sps80-SaiSingaravelan/Synthesiser-Project/SynthesizerProject_QMS/Documents gallery/Figures & Diagrams/260312-SynthesizerProject-LCA Diagram-V1.png

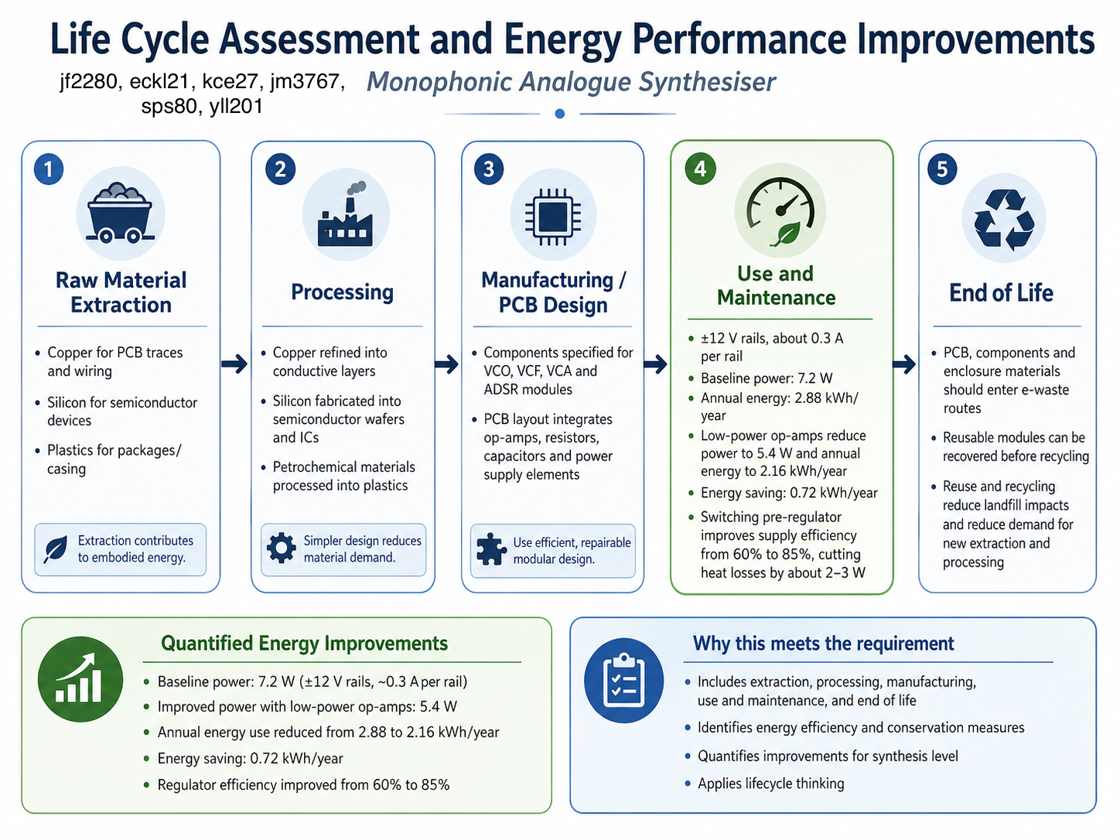
SynthesizerProject_QMS/Documents gallery/Figures & Diagrams/260312-SynthesizerProject-LCA Diagram-V1.png
