sps80-SaiSingaravelan/Synthesiser-Project/README.md

# Synthesiser-Project
This is the repository for our Modular Synthesiser Project
