sps80-SaiSingaravelan/Synthesiser-Project/SynthesizerProject_QMS/Engineering/Measurements & Screenshots/260307-Synthesizer-EEE-ASREnvSchematic-v1-00.png

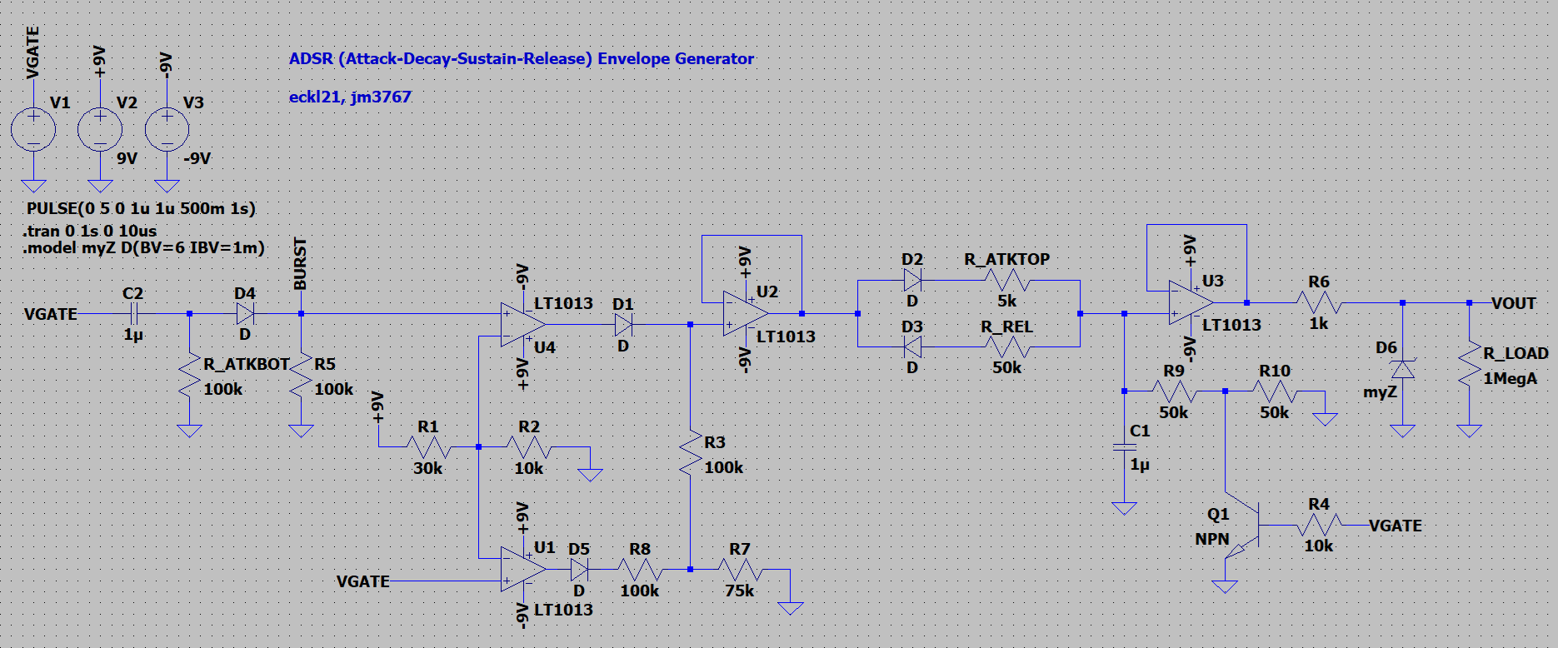
SynthesizerProject_QMS/Engineering/Measurements & Screenshots/260307-Synthesizer-EEE-ASREnvSchematic-v1-00.png
