sps80-SaiSingaravelan/Synthesiser-Project/SynthesizerProject_QMS/Engineering/PCB Layouts/ENV/20260428-Synthesizer-EEE-LT1013Symbol-v1-00.png

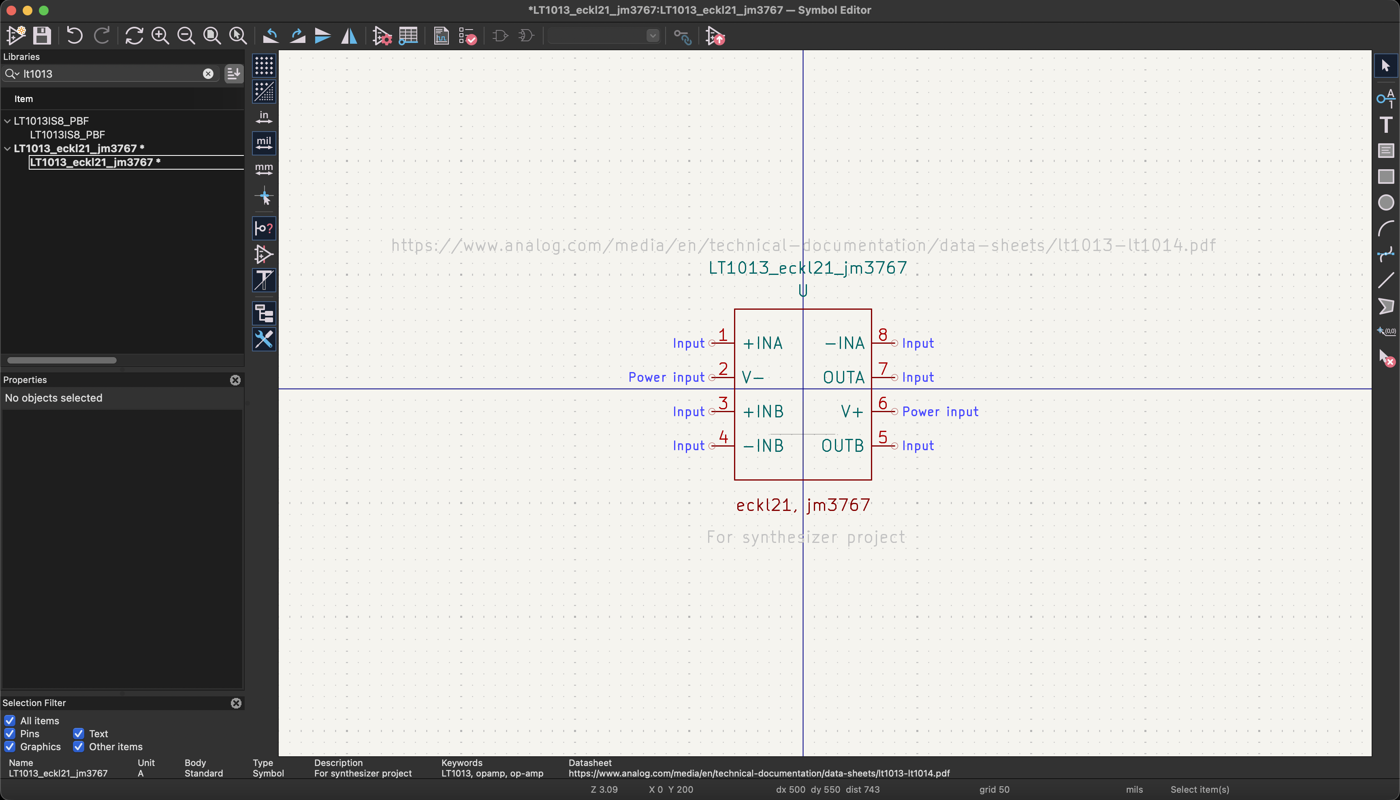
SynthesizerProject_QMS/Engineering/PCB Layouts/ENV/20260428-Synthesizer-EEE-LT1013Symbol-v1-00.png
