sps80-SaiSingaravelan/Synthesiser-Project/SynthesizerProject_QMS/Quality documents/D&D matrices/260308-SynthesizerProject-DDMatrixVCF-V1.xlsx

Sheet: Sheet1
 | VCF D&D Matrix |  |  | jm3767,eckl21,jf2280,kce27,sps80,yll201
Category | Needs analysis |  | Target specifications |  |  | Technical solution |  | Verification |  |  | Validation |  |  | Compliance
 | Ref Need | Description | Ref Spec | Description | Objectives measurable + tolerance | Possible solutions | The chosen one | Verification test description | Location/Team | Control methodology | Validation test description | Location/Team | Control methodology | Y/N
Performance | N1.1 | The synthesiser must shape the harmonic content of the VCO output using a voltage controlled filter. | S1.1 | Provide low-pass filtering of oscillator waveforms for subtractive synthesis. | Cut-off frequency adjustable from 100 Hz to 5 kHz ±10%, based on standard filter design principles [21]. | •Passive RC low-pass filter •Op-amp active low-pass filter •State-variable filter | Op-amp based active voltage controlled low-pass filter | LTspice simulation with square-wave input and confirm that cut-off point is within the target range. | 2 East Labs/ Team | Vary the control voltage in LTspice and observe the reduction of high-frequency content at the output | Perform LTspice AC sweep analysis to measure the -3 dB cut-off frequency at minimum, mid, and maximum control settings. | 2 East Labs / Team | Use AC analysis in LTspice to determine the frequency at which output amplitude drops by 3 dB relative to passband [20], [21]. Compare measured values against target range of 100 Hz to 5 kHz ±10%. | Y
Performance | N1.2 | The filter must operate over a useful part of the audible range [21] | S1.2 | Allow audible tone shaping over low to mid audio frequencies. | Usable filtering range covering at least 3 octaves, target 100 Hz to 5 kHz ±10%. | •Passive RC filter with variable resistor •Active op-amp filter •OTA filter | Active op-amp filter topology | Measure cut-off frequency at minimum and confirm coverage of the specified range. | 2 East Labs/ Team | Perform AC sweep in LTspice and record the −3 dB cut-off frequency [20], [21] | Perform AC sweep analysis to measure gain peak near the cut-off frequency at different resonance settings. | 2 East Labs / Team | Measure peak gain in LTspice frequency response and confirm it reaches at least +3 dB ±1 dB. Observe behaviour across low, medium, and high resonance settings [20], [22]. | Y
Usability | N2.1 | The VCF must accept the expected VCO signal level without significant distortion. | S2.1 | Process standard synthesiser-level audio signals without clipping in normal operation. | Input amplitude up to ±5 V ±5% without visible clipping or severe waveform deformation at the output [22]. | •Passive filter stage •Buffered active filter stage •OTA stage with buffer | Buffered op-amp active filter stage | Simulate with square-wave input and confirm output remains within supply limits and preserves expected filtered waveform shape. | 2 East Labs/ Team | Apply a ±5 V square-wave input in LTspice and inspect output waveform amplitude and shape [20]. | Apply ±5 V square wave input and observe output waveform for distortion or clipping. | 2 East Labs / Team | Perform transient simulation in LTspice and inspect waveform amplitude and shape. Confirm output remains within supply limits and preserves waveform characteristics [20]. | Y
Usability | N2.2 | The VCF must integrate with the rest of the synthesiser signal chain. | S2.2 | Accept VCO output and provide an output suitable for the following VCA stage. | Input impedance high enough and output amplitude maintained within ±5 V ±10% under nominal test conditions. | •Passive coupling stage •Op-amp buffered filter •OTA filter with output buffer | Op-amp based resonant filter with buffering | Simulate VCO-to-VCF connection in LTspice and confirm stable signal transfer and expected filtered output. | 2 East Labs/ Team | Connect the simulated VCO source to the VCF input and inspect output level and waveform stability. | Connect simulated VCO output to VCF input and verify signal transfer and stability. | 2 East Labs / Team | Simulate full signal chain in LTspice and observe output waveform. Confirm stable operation, correct amplitude, and expected filtering behaviour [20], [21]. | Y
Aesthetic | N3 | The filter should provide resonance to make the sound more characterful. | S3 | Provide adjustable resonance around the cut-off frequency. | Clearly visible gain peak near cut-off, with peak magnitude change of at least +3 dB ±1 dB [21], [22]. | •State-variable filter •Ladder filter •Active low-pass filter with feedback | Active low-pass filter with feedback | Use AC analysis to compare low-resonance and high-resonance responses and confirm an increased peak near cut-off [20], [22]. | 2 East Labs/ Team | Adjust the resonance feedback parameter in LTspice and compare frequency response plots. | Adjust resonance control and observe smooth variation in peak response. | 2 East Labs / Team | Perform AC sweep at multiple resonance settings and compare frequency response plots. Confirm gradual increase in peak gain without abrupt changes [20], [22]. | Y
Societal | N4 | The design must be safe and suitable for use in a university laboratory. | S4 | Operate only from safe low-voltage supplies commonly available in teaching labs. | Supply rails limited to ±12 V to ±15V, supply variation of ±5% [21] | •Low voltage op-amp circuit •Higher voltage discrete analogue circuit | Low voltage op-amp circuit | Check the LTspice supply configuration and confirm no part of the design requires hazardous voltage levels. | 2 East Labs/ Team | Confirm from schematic that all active devices operate within their rated supply limits. | Verify circuit operates within safe voltage limits. | 2 East Labs / Team | Inspect LTspice schematic and simulation parameters to confirm supply rails remain within ±12 V typical lab limits [20], [21]. | Y
Sustainability | N5 | The filter should use components that are easy to source, replace and reuse. | S5 | Use standard analogue components suitable for breadboard reuse and low-waste prototyping. | Use only standard resistors, capacitors and common op-amps available in the university lab; target 100% | •Custom IC filter module •Discrete transistor filter •Standard op-amp filte | Standard op-amp based filter | Confirm that all simulated components correspond to common laboratory parts | 2 East Labs/ Team | Compare parts list to available parts in lab | Verify components used are standard and available in lab. | 2 East Labs / Team | Compare component list in LTspice schematic against commonly available resistors, capacitors, and op-amps used in analogue circuit design [21]. | Y
Business | N6 | The design must be feasible within student time, cost and equipment constraints. | S6 | Keep the design simple enough to simulate, explain and prototype. | Circuit to use a manageable component count, e.g. fewer than 20 main components ±2 | •Complex ladder VCF •OTA VCF •Simple active op-amp VCF | Simple active op-amp VCF | Confirm that all expected testing can be done in the lab | 2 East Labs/ Team | Main components in the schematic should be testable with standard lab equipment. | Verify circuit complexity is suitable for student implementation. | 2 East Labs / Team | Evaluate circuit component count and successful LTspice simulation. Confirm design can be implemented within project constraints [21]. | Y

Sheet: Sheet2
IEEE References
[1] Analog Devices, “LTspice Simulation Software,” [Online]. Available: https://www.analog.com/ltspice. Accessed: Mar. 8, 2026.
[2] A. S. Sedra and K. C. Smith, Microelectronic Circuits, 7th ed. Oxford, U.K: Oxford University Press, 2015.
[3] D. Self, Small Signal Audio Design, 3rd ed. Oxford, U.K.: Focal Press, 2020.
