sps80-SaiSingaravelan/Synthesiser-Project/SynthesizerProject_QMS/Quality documents/D&D matrices/260308-Synthesizerproject-ENVELOPED&D-V1.xlsx

 |  | jm3767,eckl21,jf2280,kce27,sps80,yll201
category | Needs analysis |  | Target specifications |  |  |  | technical specification |  | verification |  |  | Validation
 | Ref Need | Description | Ref Spec | Description | Objectives measurable + tolerance | objective tolerance | technical solutions | alternative | test description | location/team | control methodology | Validation test description | Location/Team | Control methodology
Performance | N1.1 | The system must generate an ADSR envelope to shape audio amplitude. | S1.1 | Envelope output waveform | Output must show attack, decay, sustain and release behaviour. | 0–6 V output ±10% | Analog ADSR circuit using LT1013 op-amps, RC timing and diodes. | Digital envelope generator using microcontroller or FPGA. | Apply gate pulse and observe Vout waveform. | 2 East building labs / Team | Waveform measurement using simulation cursors. | Confirm ADSR behaviour during gate pulse. | 2 East building labs / Team | Envelope waveform matches ADSR profile.
Performance | N1.2 | The system must allow adjustable attack time. | S1.2 | Attack timing control | Attack must be adjustable via RC network. | 10–200 ms ±10% | Attack controlled using R_ATKTOP, R_ATKBOT, capacitors (C1, C2), and diode network (D2, D3) | Implement comparator and transistor switching | Measure rise time of Vout. | 2 East building / Team | Cursor time measurement. | Verify attack speed changes when resistance changes. | 2 East building / Team | Envelope rise time responds to control adjustments.
Performance | N1.3 | The system must maintain a stable sustain level while the gate signal is active. | S1.3 | Sustain voltage level | Sustain voltage must remain constant during gate high period and after trigger falls below threshold | ~2 V ±10% | Sustain control using resistor divider network (R9, R10) and comparator. | Digital sustain level control. | Measure sustain plateau voltage. | 2 East building / Team | Voltage measurement at sustain stage. | Verify sustain level remains stable. | 2 East building / Team | Stable voltage observed during sustain stage.
Performance | N1.4 | The envelope must decay smoothly when the gate signal ends. | S1.4 | Release time control | Release time controlled via capacitor discharge path. | 50–500 ms ±10% | Release controlled using R_REL and diode network (D2, D3). | Substitute capacitor with active transistor discharge circuit. | Measure Vout decay after gate drop. | Lab PC / Individual | Time measurement using cursors. | Confirm smooth exponential decay to zero. | Lab PC / Individual | Release behaviour confirmed.
Usability | N2.1 | Users must be able to adjust envelope parameters easily. | S2.1 | Control interface | Controls must allow manual adjustment of envelope parameters. | Simple knob adjustment. | Potentiometers controlling attack and release resistance. | Using sliders | Adjust resistance values and observe waveform changes. | Lab / Team | Parameter sweep testing. | User can modify envelope shape easily. | Lab / Team | Parameter control verified.
Usability | N2.2 | The circuit must respond reliably to gate signals. | S2.2 | Gate signal compatibility | Circuit must trigger correctly from input signal. | Gate range 0–5 V ±10%. | VGATE input triggering the envelope circuit. | Comparator or Schmitt trigger input stage. | Apply pulse signal and observe envelope triggering. | Lab / Team | Signal generator testing. | Envelope triggered correctly for each pulse. | Lab / Team | Reliable triggering confirmed.
Societal | N3.1 | The circuit must operate safely in laboratory environments. | S3.1 | Electrical safety | Circuit must operate at safe voltage levels. | Supply voltage < ±12 V. | ±9 V supply powering LT1013 op-amps. | ±12 V synthesiser supply. | Measure supply voltages during operation. | Lab / Team | Multimeter measurement. | Verify circuit operates within safe limits. | Lab / Team | Safe voltage levels confirmed.
Sustainability | N4.1 | The design should minimise energy consumption. | S4.1 | Power efficiency | Use low power components. | <50 mA estimated consumption. | LT1013 low power operational amplifiers. | High power op-amp circuits. | Estimate current from datasheets. | Lab / Individual | Datasheet analysis. | Verify power consumption within limits. | Lab / Individual | Low power operation confirmed.
Sustainability | N4.2 | The circuit should minimise material usage. | S4.2 | Component count | Design should use minimal electronic components. | <20 discrete components. | Analog envelope generator with minimal RC network. | Microcontroller-based design requiring more components. | Count components in circuit design. | Lab / Team | BOM inspection. | Verify minimal component usage. | Lab / Team | Efficient component use confirmed.
Aesthetic | N5.1 | The circuit should be compact for integration into a synthesiser system. | S5.1 | Physical footprint | Circuit must fit on small PCB module. | Around a 762mm board size. | Compact analog circuit layout. | Breadboard prototype design. | Inspect PCB layout dimensions. | Lab / Team | Visual inspection. | Verify design suitable for module integration. | Lab / Team | Size requirement satisfied.
Business | N6.1 | The design must be cost effective to manufacture. | S6.1 | Component cost | Total bill of materials must remain within budget. | <£20 BOM. | Discrete resistors, capacitors and op-amps. | Microcontroller or FPGA based design. | Estimate component costs from suppliers. | Desk-based / Team | Compare prices with BOM. | Verify design meets cost target. | Desk-based / Team | Cost requirement met.
Inclusion | N7.1 | The system should be accessible to users with limited electronics knowledge. | S7.1 | Ease of use | Controls must be simple and intuitive. | Envelope parameters adjustable with simple controls. | Potentiometer-based controls for ADSR parameters. | Digital interface requiring programming. | Observe user adjusting controls. | Lab / Team | User testing. | New user able to operate system easily. | Lab / Team | Usability confirmed.
Standards | N8.1 | The design must comply with common electronic component standards. | S8.1 | Component standards | Use industry standard component values. | component values. ±5% tolerance components. | Standard resistor and capacitor values. | Custom components outside standard ranges. | Check components against datasheets. | Lab / Team | Component verification. | Confirm compliance with design standards. | Lab / Team | Standards requirement satisfied.
Safety | N9.1 | The circuit must operate safely without risk of electrical hazard. | S9.1 | Safe operating conditions | Low voltage operation to prevent electrical risk. | Operating voltage < ±12 V. | ±9 V regulated supply design. | Mains powered system. | Measure operating voltages. | Lab / Team | Multimeter testing. | Confirm no hazardous voltage present. | Lab / Team | Electrical safety verified.
