sps80-SaiSingaravelan/Synthesiser-Project/SynthesizerProject_QMS/Quality documents/D&D matrices/260311-Synthesizerproject-Envelopedecisionandchoicematrix-V1.xlsx

Choice Matrix 1 — Envelope Generation Method
jm3767,eckl21,jf2280,kce27,sps80,yll201
Decision: Select the method used to generate the ADSR envelope waveform for shaping audio amplitude.
Decision criteria and weighting |  |  |  |  |  |  |  | Conclusion: The choice matrices demonstrate that an analog ADSR envelope generator using RC timing networks and LT1013 operational amplifiers best satisfies the project’s target specifications. The analog architecture achieved the highest weighted scores due to its low component count, low power consumption, cost efficiency, and ease of implementation. Supporting design decisions such as potentiometer-based controls, a direct gate trigger input, and a + or - 9 V supply further improve usability, reliability, and safety. Overall, the selected solutions provide a stable, adjustable envelope generator suitable for integration within a compact synthesiser module.
Criterion | Link to target specs | Weight (%)
Envelope waveform accuracy | S1.1 | 30
Implementation complexity | S4.2 | 25
Component count | S4.2 | 15
Power consumption | S4.1 | 15
Cost & availability | S6.1 | 10
Ease of implementation | S2.1, S7.1 | 5
Total |  | 100
Choice Matrix (1–5)
Option | Envelope waveform accuracy (30) | Implementation complexity (25) | Component count (15) | Power consumption (15) | Cost & availability (10) | Ease of implementation (5) | Total
Analog ADSR circuit | 4×30 = 120 | 5×25 = 125 | 4×15 = 60 | 4×15 = 60 | 5×10 = 50 | 4×5 = 20 | 435
Digital envelope generator | 5×30 = 150 | 3×25 = 75 | 3×15 = 45 | 3×15 = 45 | 3×10 = 30 | 3×5 = 15 | 360
Selected solution: Analog ADSR circuit
Choice Matrix 2 — Attack Time Control
jm3767,eckl21,jf2280,kce27,sps80,yll201
Decision: Select the method used to control the attack timing of the ADSR envelope.
Decision criteria and weighting
Criterion | Link to target specs | Weight (%)
Adjustable timing accuracy | S1.2 | 35
Implementation simplicity | S2.1 | 25
Circuit reliability | S3.1 | 15
Component cost | S6.1 | 15
Ease of user control | S7.1 | 10
Total |  | 100
Choice Matrix (1–5)
Option | Adjustable timing accuracy (35) | Implementation simplicity (25) | Circuit reliability (15) | Component cost (15) | Ease of user control (10) | Total
RC timing network + diode network | 5×35 = 175 | 4×25 = 100 | 4×15 = 60 | 4×15 = 60 | 5×10 = 50 | 445
RC timing network + diode network + comparator and transistor switching | 2×35 = 70 | 5×25 = 125 | 4×15 = 60 | 5×15 = 75 | 2×10 = 20 | 350
Selected solution: RC timing network
Choice Matrix 3 — Sustain Level Control
jm3767,eckl21,jf2280,kce27,sps80,yll201
Decision: Select the method used to control the sustain voltage level of the ADSR envelope.
Decision criteria and weighting
Criterion | Link to target specs | Weight (%)
Voltage stability | S1.3 | 35
Circuit simplicity | S4.2 | 25
Cost & availability | S6.1 | 15
Power efficiency | S4.1 | 15
Ease of implementation | S2.1 | 10
Total |  | 100
Choice Matrix (1–5)
Option | Voltage stability (35) | Circuit simplicity (25) | Cost & availability (15) | Power efficiency (15) | Ease of implementation (10) | Total
Resistor divider network | 4×35 = 140 | 5×25 = 125 | 5×15 = 75 | 4×15 = 60 | 4×10 = 40 | 440
Digital sustain control | 5×35 = 175 | 3×25 = 75 | 3×15 = 45 | 3×15 = 45 | 3×10 = 30 | 370
Selected solution: Resistor divider network
Choice Matrix 4 — Release Time Control
jm3767,eckl21,jf2280,kce27,sps80,yll201
Decision: Select the method used to control the release stage of the ADSR envelope.
Decision criteria and weighting
Criterion | Link to target specs | Weight (%)
Smooth envelope decay | S1.4 | 35
Circuit simplicity | S4.2 | 25
Reliability | S3.1 | 15
Cost & availability | S6.1 | 15
Ease of implementation | S2.1 | 10
Total |  | 100
Choice Matrix (1–5)
Option | Smooth envelope decay (35) | Circuit simplicity (25) | Reliability (15) | Cost & availability (15) | Ease of implementation (10) | Total
RC + diode discharge network | 5×35 = 175 | 4×25 = 100 | 4×15 = 60 | 4×15 = 60 | 4×10 = 40 | 435
diode discharge network + transistor discharge circuit | 4×35 = 140 | 3×25 = 75 | 4×15 = 60 | 3×15 = 45 | 3×10 = 30 | 350
Selected solution: RC diode discharge network
Choice Matrix 5 — Envelope Parameter Control Interface
jm3767,eckl21,jf2280,kce27,sps80,yll201
Decision: Select the interface used for adjusting envelope parameters.
Decision criteria and weighting
Criterion | Link to target specs | Weight (%)
Ease of user control | S2.1, S7.1 | 35
Implementation simplicity | S4.2 | 25
Cost | S6.1 | 15
Reliability | S3.1 | 15
Power consumption | S4.1 | 10
Total |  | 100
Choice Matrix (1–5)
Option | Ease of user control (35) | Implementation simplicity (25) | Cost (15) | Reliability (15) | Power consumption (10) | Total
Potentiometer controls | 5×35 = 175 | 5×25 = 125 | 4×15 = 60 | 4×15 = 60 | 4×10 = 40 | 460
Digital push-button interface | 3×35 = 105 | 3×25 = 75 | 3×15 = 45 | 4×15 = 60 | 4×10 = 40 | 325
Selected solution: Potentiometer controls
Choice Matrix 6 — Gate Signal Trigger Method
jm3767,eckl21,jf2280,kce27,sps80,yll201
Decision: Select the method used to trigger the ADSR envelope using an input gate signal.
Decision criteria and weighting
Criterion | Link to target specs | Weight (%)
Trigger reliability | S2.2 | 35
Circuit simplicity | S4.2 | 25
Response speed | S1.1 | 15
Cost | S6.1 | 15
Ease of implementation | S2.1 | 10
Total |  | 100
Choice Matrix (1–5)
Option | Trigger reliability (35) | Circuit simplicity (25) | Response speed (15) | Cost (15) | Ease of implementation (10) | Total
Direct gate input | 5×35 = 175 | 5×25 = 125 | 5×15 = 75 | 5×15 = 75 | 4×10 = 40 | 490
Comparator trigger stage | 5×35 = 175 | 3×25 = 75 | 4×15 = 60 | 3×15 = 45 | 3×10 = 30 | 385
Selected solution: Direct gate input
Choice Matrix 7 — Supply Voltage Selection
jm3767,eckl21,jf2280,kce27,sps80,yll201
Decision: Select the supply voltage used to power the envelope circuit.
Decision criteria and weighting
Criterion | Link to target specs | Weight (%)
Electrical safety | S3.1, S9.1 | 35
Compatibility with op-amps | S1.1 | 25
Power consumption | S4.1 | 15
Circuit stability | S1.3 | 15
Cost | S6.1 | 10
Total |  | 100
Choice Matrix (1–5)
Option | Electrical safety (35) | Compatibility (25) | Power consumption (15) | Circuit stability (15) | Cost (10) | Total
±9 V supply | 5×35 = 175 | 4×25 = 100 | 4×15 = 60 | 4×15 = 60 | 4×10 = 40 | 435
±12 V supply | 4×35 = 140 | 5×25 = 125 | 3×15 = 45 | 4×15 = 60 | 4×10 = 40 | 410
Selected solution: ±9 V supply
Choice Matrix 8 — Operational Amplifier Selection
jm3767,eckl21,jf2280,kce27,sps80,yll201
Decision: Select the operational amplifier used in the envelope circuit.
Decision criteria and weighting
Criterion | Link to target specs | Weight (%)
Power efficiency | S4.1 | 35
Signal accuracy | S1.1 | 25
Cost | S6.1 | 15
Availability | S6.1 | 15
Ease of implementation | S2.1 | 10
Total |  | 100
Choice Matrix (1–5)
Option | Power efficiency (35) | Signal accuracy (25) | Cost (15) | Availability (15) | Ease of implementation (10) | Total
LT1013 op-amp | 5×35 = 175 | 4×25 = 100 | 4×15 = 60 | 4×15 = 60 | 4×10 = 40 | 435
General purpose op-amp | 3×35 = 105 | 4×25 = 100 | 4×15 = 60 | 5×15 = 75 | 4×10 = 40 | 380
Selected solution: LT1013 op-amp
Choice Matrix 9 — Envelope Circuit Architecture
jm3767,eckl21,jf2280,kce27,sps80,yll201
Decision: Select the overall architecture used to generate the ADSR envelope.
Decision criteria and weighting
Criterion | Link to target specs | Weight (%)
Component count | S4.2 | 30
Cost | S6.1 | 25
Implementation complexity | S2.1 | 25
Reliability | S3.1 | 20
Total |  | 100
Choice Matrix (1–5)
Option | Component count (30) | Cost (25) | Implementation complexity (25) | Reliability (20) | Total
Analog envelope generator | 5×30 = 150 | 5×25 = 125 | 4×25 = 100 | 4×20 = 80 | 455
Microcontroller based design | 3×30 = 90 | 3×25 = 75 | 2×25 = 50 | 4×20 = 80 | 295
Selected solution: Analog envelope generator
Choice Matrix 10 — Physical Circuit Layout
jm3767,eckl21,jf2280,kce27,sps80,yll201
Decision: Select the physical layout method for the envelope circuit.
Decision criteria and weighting
Criterion | Link to target specs | Weight (%)
Compactness | S5.1 | 35
Reliability | S3.1 | 30
Ease of integration | S2.1 | 20
Ease of testing | S2.1 | 15
Total |  | 100
Choice Matrix (1–5)
Option | Compactness (35) | Reliability (30) | Ease of integration (20) | Ease of testing (15) | Total
PCB module | 5×35 = 175 | 5×30 = 150 | 5×20 = 100 | 3×15 = 45 | 470
Breadboard prototype | 2×35 = 70 | 3×30 = 90 | 2×20 = 40 | 5×15 = 75 | 275
Selected solution: PCB module
Choice Matrix 11 — Component Cost Strategy
jm3767,eckl21,jf2280,kce27,sps80,yll201
Decision: Select the component strategy used to meet cost requirements.
Decision criteria and weighting
Criterion | Link to target specs | Weight (%)
Component cost | S6.1 | 40
Availability | S6.1 | 25
Reliability | S3.1 | 20
Ease of sourcing | S8.1 | 15
Total |  | 100
Choice Matrix (1–5)
Option | Component cost (40) | Availability (25) | Reliability (20) | Ease of sourcing (15) | Total
Discrete components | 5×40 = 200 | 5×25 = 125 | 4×20 = 80 | 4×15 = 60 | 465
Microcontroller solution | 2×40 = 80 | 3×25 = 75 | 4×20 = 80 | 3×15 = 45 | 280
Selected solution: Discrete components
Choice Matrix 12 — Accessibility Design
jm3767,eckl21,jf2280,kce27,sps80,yll201
Decision: Select the control method used to ensure accessibility for new users.
Decision criteria and weighting
Criterion | Link to target specs | Weight (%)
Ease of use | S7.1 | 40
Learning curve | S2.1 | 25
Implementation simplicity | S4.2 | 20
Reliability | S3.1 | 15
Total |  | 100
Choice Matrix (1–5)
Option | Ease of use (40) | Learning curve (25) | Implementation simplicity (20) | Reliability (15) | Total
Potentiometer controls | 5×40 = 200 | 5×25 = 125 | 4×20 = 80 | 4×15 = 60 | 465
Digital programming interface | 2×40 = 80 | 2×25 = 50 | 3×20 = 60 | 4×15 = 60 | 250
Selected solution: Potentiometer controls
Choice Matrix 13 — Component Standards
jm3767,eckl21,jf2280,kce27,sps80,yll201
Decision: Select the component specification approach used for the circuit.
Decision criteria and weighting
Criterion | Link to target specs | Weight (%)
Availability | S8.1 | 35
Cost | S6.1 | 25
Reliability | S3.1 | 25
Manufacturing ease | S5.1 | 15
Total |  | 100
Choice Matrix (1–5)
Option | Availability (35) | Cost (25) | Reliability (25) | Manufacturing ease (15) | Total
Standard components | 5×35 = 175 | 5×25 = 125 | 4×25 = 100 | 5×15 = 75 | 475
Custom components | 2×35 = 70 | 3×25 = 75 | 4×25 = 100 | 2×15 = 30 | 275
Selected solution: Standard components
Choice Matrix 14 — Electrical Safety Design
jm3767,eckl21,jf2280,kce27,sps80,yll201
Decision: Select the power design used to ensure safe operation of the circuit.
Decision criteria and weighting
Criterion | Link to target specs | Weight (%)
Electrical safety | S9.1 | 40
Implementation complexity | S4.2 | 25
Cost | S6.1 | 20
Reliability | S3.1 | 15
Total |  | 100
Choice Matrix (1–5)
Option | Electrical safety (40) | Implementation complexity (25) | Cost (20) | Reliability (15) | Total
Low voltage supply | 5×40 = 200 | 4×25 = 100 | 4×20 = 80 | 4×15 = 60 | 440
Mains powered design | 1×40 = 40 | 2×25 = 50 | 3×20 = 60 | 4×15 = 60 | 210
Selected solution: Low voltage supply
