sps80-SaiSingaravelan/Synthesiser-Project/SynthesizerProject_QMS/Quality documents/D&D matrices/260313-SynthesizerProject-VCOFeasibilitySudy-V1.xlsx

Sheet: Cover
EE22005 Feasibility Study – Design & Development Matrix
Project | Voltage-Controlled Oscillator (VCO) — musical synthesiser module
Topology | Relaxation oscillator with exponential V→I converter, triangle + square outputs
Document | EE22005_DDMatrix_VCO_v1.0.xlsx
Version | v1.0
Date | 2026-04-22
Author(s) | John Pork + [Team Members]
Unit | EE22005 — Engineering Practice and Design (Year 2)
Skill | 1.1 Feasibility Study — Application + Synthesis
Supply / Standard | ±12 V dual rail, Eurorack-compatible (Doepfer A-100)
Change log
Version | Date | Author | Change | Reviewed by | Status
v1.0 | 2026-04-22 | J. Pork | Initial issue for feasibility study | — | Draft
Contents
Cover | Title, version metadata, change log
D&D Matrix | Full design & development matrix (needs → validation + compliance)
Choice-Topology | Weighted scoring: overall VCO core topology
Choice-Shape | Weighted scoring: waveform generation method
Choice-ExpoConv | Weighted scoring: exponential V-to-I converter
Choice-Tempco | Weighted scoring: temperature-compensation strategy
Weights Rationale | Explanation of each criterion + weight assigned
Assumptions | Stated design assumptions and their justification
References | Sources used throughout the feasibility study

Sheet: D&D Matrix
Needs analysis |  | Target specifications |  |  | Technical solution |  | Verification |  |  | Validation |  |  | Compliance
Ref need | Description (user need) | Ref spec | Description | Objective (measurable + tolerance) | Possible / alternative solutions | Chosen technical solution | Verification test description | Location / team | Control methodology | Validation test description | Location / team | Control methodology | Y/N
N1 | Functional — produce simultaneous triangle and square audio waveforms, amplitude-controlled by CV, to serve as the primary audio source of a modular-synth voice [1] | TS1 | Two simultaneous outputs: TRIANGLE and SQUARE available on separate buffered ports | Triangle ≥ 4 Vpp ±10 %; Square ≥ 9 Vpp ±10 %; both DC-coupled; 20 Hz – 20 kHz | • Integrator + Schmitt comparator (relaxation) • LM555 astable with pseudo-triangle at timing cap • Analogue VCO (LC) with waveform shaper • Digital NCO + DAC • Ring oscillator + shaper | Op-amp integrator (U2, 3.89 nF) driven by expo current; Schmitt comparator (U5) with Q3 current-switch produces square; U6 buffers both outputs [2] | Measure Vpp of TRIANGLE and SQUARE at 100 Hz, 1 kHz, 10 kHz with 100 kΩ/10 pF scope probe | Lab 3.28 / J. Pork + team | Keysight DSOX1204G oscilloscope calibrated; 3 readings avg. | A-B listening test through commercial synth amplifier; confirm both outputs audible and musically usable | Project studio / team | Subjective comparison against Doepfer A-110-1 reference VCO | Y
N2 | Functional — the musician must be able to play 1 V/octave pitched notes using a standard keyboard/sequencer CV, as required for compatibility with the wider synth ecosystem [3] | TS2 | Exponential CV scaling of 1 V/oct (KEY input) with ≤ ±5 cents tracking error over 5 consecutive octaves (Doepfer A-100 convention) | Tracking error |Δ| ≤ 5 cents for KEY = 0…5 V at 25 °C ± 2 °C | • Discrete matched NPN pair (Q1/Q2) + tempco (chosen) • SSM2210 matched-pair IC • CEM3340 / AS3340 dedicated VCO IC • Log diode (single junction) • Microcontroller + DAC (digital expo) | Matched NPN pair Q1/Q2 with emitter tempco resistor; 1 MΩ base (R6) limits base current; CV mixed through R1/R3/R4 into U1 summing node | Sweep KEY from 0 V to 5 V in 1 V steps; measure output frequency; compute semitone error vs. f(V)=f₀·2^V | Lab 3.28 / J. Pork + team | HP 53131A frequency counter, 0.1 ppm timebase; 5-point test per octave | Tune oscillator to A4 (440 Hz) then play two-octave scale on MIDI/CV keyboard; record and compare in tuner app | Studio / team | TE Tuner / Peterson StroboPlus HD reference | Y
N3 | Functional — user needs to fine-tune pitch and receive linear FM from an LFO for musical expression (vibrato, trills, sync) [1] | TS3 | Two additional CV inputs: TUNE (DC, ±1 V ≈ ±1 oct) and LFO (AC-coupled linear FM, ±5 V) | TUNE gain 1 oct/V ±10 %; LFO FM depth ≥ ±1 semitone at 5 Hz, ±5 V input | • Summed at U1 virtual earth (chosen) • Separate op-amp for each CV then analog adder • Digital CV mixer (ADC+DSP) • Passive resistor mixer into expo base (no buffer) | All three CVs mixed through equal 100 kΩ resistors (R1, R3, R4) into inverting summing amp U1; R2=1.8 kΩ sets overall gain | Inject sine at LFO input (5 Vpp, 5 Hz); measure peak-to-peak pitch deviation at output | Lab 3.28 / team | Function gen Keysight 33500B; counter reading per cycle | Listening test with LFO at 5 Hz; confirm pleasing vibrato depth | Studio / team | Peer review checklist | Y
N4 | Performance — VCO must cover the human-audible range so the instrument can play from sub-bass to highest musical partials [1] | TS4 | Output frequency range 20 Hz ≤ f ≤ 20 kHz across the KEY input sweep of 0 – 10 V | fmin ≤ 20 Hz (+0/−0.5 Hz); fmax ≥ 20 kHz (no upper tolerance) | • Integrator-comparator (chosen) • 555 astable (limited by CV range) • LC Colpitts (audio range unsuitable) • Ring oscillator (temp. dep.) | Integrator capacitor C2 = 3.89 nF with current source derived from expo converter; R7 = 30 kΩ feedback scales current | Sweep KEY 0 → 10 V; log frequency at each 1 V step; confirm monotonic and within limits | Lab 3.28 / team | Frequency counter + automated LabVIEW sweep | Musical check: play lowest and highest keys on MIDI controller; confirm audible pitch | Studio / team | Peer subjective review | Y
N5 | Performance — the VCO must stay in tune during a performance even as ambient/PCB temperature drifts, or musicians will constantly have to re-tune [4] | TS5 | Tuning drift ≤ 10 cents/°C between 10 °C and 40 °C (Eurorack typical spec) | |Δf/f| ≤ 0.58 %/°C equivalently; measured at A4=440 Hz | • Discrete BJT pair, no compensation (rejected – 3300 ppm/°C drift) • Q1/Q2 + PTC tempco resistor (+3300 ppm/°C) in emitter (chosen) • Matched-pair IC (SSM2212/SSM2210) with on-die match • Temperature-controlled oven (overkill) | Q1/Q2 thermally coupled (shared heatsink clip); R5 = 1 kΩ assumed PTC tempco; planned upgrade path to SSM2212 | Soak VCO inside thermal chamber; measure pitch at 10, 25, 40 °C after 15 min dwell each; compute Δcents/°C | Environmental lab / team | ESPEC SH-262 chamber (±0.5 °C); counter logs via GPIB | Play same note daily for a week in studio (varying temperature); log tuner readings | Studio / J. Pork | Log sheet, tuner app, diary | Y
N6 | Performance — triangle wave must be linear so harmonic content remains musical (soft, odd+even harmonics) rather than distorted [5] | TS6 | Triangle wave THD ≤ 1 % from 100 Hz to 5 kHz (fundamental + 9 harmonics) | THD measured via FFT; noise floor < −60 dBc | • Integrator (chosen; intrinsically linear if I_charge is constant) • RC charging (exponential, not acceptable) • DAC/digital (quantisation noise) • Analogue sine + comparator (no triangle) | Integrator U2 with constant-current charge from expo stage; symmetry controlled by matched current sink/source via Q3 switch | Capture TRIANGLE at 1 kHz with DSO; FFT; compute THD over 10 harmonics | Lab 3.28 / team | Keysight DSOX1204G + built-in FFT; 3 captures averaged | Plug into commercial low-pass filter + VCA; record audio sample and peer review | Studio / team | Peer A/B vs. Doepfer VCO | Y
N7 | Performance — the square output should be symmetrical (50 % duty) so harmonic spectrum is the classic odd-harmonic square expected by musicians [5] | TS7 | Square wave duty cycle 50 % ± 2 % from 100 Hz to 10 kHz | Duty = t_high / T; tolerance ±2 % | • Schmitt-trigger comparator with VREF centred (chosen) • PWM DAC (complex) • Monostable + /2 flip-flop (adds parts) | Comparator U5 with symmetrical thresholds set by R13/R12 divider from VREF (mid-rail) | Measure t_high and T on DSO across freq decades; compute duty | Lab 3.28 / team | DSO cursor measurement, 3 samples per frequency | Listening test — confirm expected square-wave timbre | Studio / team | Peer review | Y
N8 | Usability — player shouldn't have to choose between waveforms; outputs must survive cable shorts and patching to any load [1] | TS8 | Both outputs available simultaneously; output impedance ≤ 1 kΩ; short-circuit to ±12 V survives indefinitely | Zout ≤ 1 kΩ ±10 %; shorted output: Iout ≤ 25 mA | • Op-amp voltage follower (U6) + series R (chosen) • Direct comparator output (no buffer — brittle) • Emitter follower (DC offset issue) | U6 non-inverting buffer; R14 (14 kΩ) + R15 (1 kΩ) set 1 kΩ output impedance; op-amp current limit protects against shorts | Short each output to GND for 60 s; measure current with DMM; re-check waveform afterwards | Lab 3.28 / team | Keysight 34465A DMM; thermal camera | Field trial — patch into a Eurorack chain for 1-hour session | Studio / team | Fault log book | Y
N9 | Health & Safety — the module must be safe to touch and operate in a performance setting; no exposed hazardous voltages; compliant with BS EN 61010-1 principles [6] | TS9 | Supply ±12 V (SELV); no voltages > 60 V_DC anywhere on the PCB | All nets ≤ ±12 V ±5 %; creepage ≥ 1.5 mm | • SELV ±12 V Eurorack bus (chosen) • Mains-isolated linear supply (out-of-scope) • USB-C 5 V + charge pump (non-standard) | PCB connector is standard Eurorack 2×5 IDC; no mains parts; pin 1 clearly marked for polarity | Inspect final PCB with DMM for highest node voltage across all CV sweeps + fault injection | Lab 3.28 / team | HiPot not required (SELV); DMM point-to-point | Independent design review by Dr Pigeon | University / tutor | Review form signed | Y
N10 | Diversity & Inclusion — the control interface should be accessible to players using adaptive/assistive controllers (breath, foot, eye-gaze), which all speak standard CV [7] | TS10 | All CV inputs use 3.5 mm TS mono jack, impedance ≥ 100 kΩ, accept 0 V – +10 V (KEY) / ±5 V (LFO) | Zin ≥ 100 kΩ; full-scale 0-10 V; no clipping below clip threshold | • 3.5 mm TS (chosen, Doepfer standard) • 1/4″ TS (Moog standard – larger) • Banana (Buchla standard – non-stock) | R1, R3, R4 = 100 kΩ from each jack tip to U1 virtual earth gives Zin ≈ 100 kΩ each | Drive each input with Zout = 1 kΩ source; confirm no loading/droop | Lab 3.28 / team | Function generator + DMM | Test with Artiphon / adaptive MIDI-to-CV interface | Accessibility testbench / team | User-experience interview | Y
N11 | Environmental — the module should minimise energy use and hazardous materials to lower lifecycle impact and meet EU RoHS legislation [8] | TS11 | RoHS 3 compliant (2015/863); total power draw ≤ 0.72 W (30 mA × ±12 V) | Datasheet evidence of RoHS for each BOM line; supply current ≤ 30 mA / rail | • Standard RoHS op-amps (TL074 / MCP6024) – chosen • Older leaded op-amps (NE5532 OB) – avoid • Through-hole vs. SMD — SMD lower mass/shipping | All ICs specified as RoHS on BOM; static current design-budgeted at 22 mA/rail (4×2 mA op-amps + biasing) | Measure quiescent current from each rail with no load; verify each BOM RoHS certificate | Lab 3.28 / team | DMM on supply rail; BOM cross-check | Supplier RoHS declaration archived in QMS | Procurement / team | QMS document register | Y
N12 | Commercial — the VCO should be affordable for hobbyist synth builders (the dominant market), targeting a retail of ~£40–£60 kit [9] | TS12 | BOM cost ≤ £15/unit at 100-off (Farnell / Mouser 2026 prices); through-hole preferred for DIY build | Rolled-up BOM cost from procurement sheet ≤ £15 | • Discrete op-amps (TL074) + BJT pair — low cost (chosen) • Dedicated IC (AS3340 ~£9) — higher cost, fewer parts • MCU + DAC — medium cost, firmware overhead | TL074 + 2N3904 matched pair; film cap for C2; 1 % resistors; estimated £8.50 BOM at 100-off | Produce roll-up BOM spreadsheet with live Farnell part numbers and unit price at 100-off | Procurement / team | BOM review + 3-quote checklist | Procure 10-unit prototype batch; record actual spend | Team purchasing | Purchase-order archive | Y
N13 | Codes of practice — must mechanically and electrically comply with Doepfer A-100 specification so it fits any standard rack and patches correctly [10] | TS13 | Doepfer A-100 compliance: 3U height, HP width multiples of 5.08 mm; signal ±5 V audio, +5 V gates, 1 V/oct CV | Panel height 128.5 mm; 10-pin power header polarity matches A-100 bus | • Doepfer A-100 (chosen) • Buchla 200e (non-stock) • MU/5U Moog format (physical mismatch) | 3U panel, 8 HP; 10-pin IDC matches Doepfer bus pinout (−12 V / +12 V / GND / GATE / CV) | Mechanical fit check in Tiptop 84HP rack; electrical: 10 pts DMM against Doepfer spec | Lab / team | Drawing + DMM checklist | Patch into 3 popular racks at local synth meetup | Studio / team | Field report | Y
N14 | Industry standards & regulations — the product must not interfere with other equipment and must tolerate normal environment emissions (EN 55032/EN 55035 Class B) [11] | TS14 | Meet EN 55032 Class B conducted + radiated emissions when powered from compliant Eurorack PSU | Margin ≥ 6 dB against Class B limits across 150 kHz – 1 GHz | • Ferrite-bead on each rail + decoupling caps (chosen) • Separate analog/digital ground (not needed – all analog) • Shielded enclosure only (not practical in open rack) | 100 nF ceramic + 10 µF electrolytic at each IC pair; BLM18 ferrite beads in series with ±12 V rails | Pre-compliance scan with near-field probe + spectrum analyser at lab bench; compare against CISPR limits | University EMC cell / team | R&S FSV pre-compliance rig, 150 kHz–1 GHz | Formal EMC test at accredited house (if commercialised) | External test house | Accredited test report | N (not yet formally tested)

Sheet: Choice-Topology
Choice matrix — overall VCO core topology
Problem statement | Which oscillator architecture best satisfies the user needs for a musical 1 V/oct VCO covering 20 Hz–20 kHz with triangle+square outputs?
Criterion | Weight | Op-amp relaxation (integrator + Schmitt) | 555 timer astable | Ring oscillator (CMOS inverters) | LC Colpitts + shaper | Wien-bridge + AGC | Rationale for weight
1 V/oct compatibility (TS2, TS4) | 0.25 | 5 | 1 | 1 | 2 | 1 | Non-negotiable for musical use — drives highest weight.
Frequency range 20 Hz–20 kHz (TS4) | 0.15 | 5 | 3 | 5 | 2 | 3 | Full audio band; 10 octaves.
Waveform quality / linearity (TS6, TS7) | 0.15 | 4 | 2 | 2 | 4 | 5 | Determines musical timbre quality.
BOM cost (TS12) | 0.10 | 5 | 5 | 5 | 3 | 3 | Target ≤ £15/unit at 100-off.
Part availability 2026 (TS12) | 0.10 | 5 | 5 | 5 | 4 | 5 | Must be sourceable now; includes post-CEM3340 shortages.
Circuit complexity / build time (TS8) | 0.10 | 4 | 5 | 4 | 3 | 2 | Affects DIY appeal and project schedule.
Temperature stability (TS5) | 0.15 | 4 | 3 | 2 | 3 | 3 | Player must not need to retune every 10 min.
Σ weights (must = 1.00) | 1.00
Weighted total (out of 5) |  | 4.60 | 2.95 | 3.00 | 2.85 | 2.90
Rank |  | 1 | 3 | 2 | 5 | 4
Conclusion | The op-amp relaxation topology wins on the weighted score and is the only alternative that naturally supports 1 V/oct exponential scaling together with simultaneous triangle + square outputs. It is adopted as the chosen architecture — identical in principle to the EE12001_DD_2425 design block [2].
Constraints / limitations | Relaxation oscillators can suffer from slew-rate limits above ~20 kHz with TL07x op-amps; this is accepted since our upper target is 20 kHz. LC topology scored high on waveform purity but fails on audio-band coverage with reasonable component values — excluded on a hard constraint, not score.

Sheet: Choice-Shape
Choice matrix — waveform generation method
Problem statement | Within the chosen relaxation architecture, how do we produce the triangle and square waveforms with acceptable linearity and duty symmetry?
Criterion | Weight | Integrator + comparator (charge/discharge) | RC exponential + comparator | Digital NCO + DAC | Analogue sine + Schmitt | Rationale for weight
Triangle linearity (TS6) | 0.30 | 5 | 1 | 4 | 2 | Direct driver of THD spec.
Square symmetry (TS7) | 0.15 | 5 | 4 | 5 | 5 | 50 % ±2 % duty.
Circuit complexity | 0.15 | 4 | 5 | 2 | 3 | Affects schedule & QMS.
Cost (TS12) | 0.10 | 5 | 5 | 2 | 4 | BOM target.
Frequency range (TS4) | 0.15 | 5 | 4 | 4 | 3 | Must hit 20 kHz.
Phase noise / jitter | 0.15 | 4 | 3 | 3 | 5 | Audible warble; less critical than pitch accuracy but contributes to timbre.
Σ weights (must = 1.00) | 1.00
Weighted total (out of 5) |  | 4.70 | 3.20 | 3.50 | 3.40
Rank |  | 1 | 4 | 2 | 3
Conclusion | The integrator + comparator approach (U2 / C2 with Q3 as current switch, U5 Schmitt) wins decisively because triangle linearity is guaranteed by constant-current charge of the integrator capacitor. This matches the implemented schematic and requires no additional shaping circuitry.
Constraints / limitations | Linearity is only as good as the constant-current source of the expo stage — bench testing must confirm the integrator current is flat over temperature and CV range (covered by TP-002).

Sheet: Choice-ExpoConv
Choice matrix — exponential V-to-I converter
Problem statement | How do we map the summed CV from U1 to an exponential current into the integrator, with ≤ ±5 cents tracking and ≤ 10 cents/°C drift?
Criterion | Weight | Discrete NPN pair (2N3904 matched, Q1/Q2) | SSM2212 / SSM2210 matched-pair IC | CEM3340 / AS3340 dedicated VCO IC | Log diode (single junction) | MCU + 12-bit DAC | Rationale for weight
Tracking accuracy (TS2) | 0.25 | 3 | 5 | 5 | 2 | 3 | Target ≤ ±5 cents / 5 oct.
Thermal drift (TS5) | 0.20 | 2 | 5 | 5 | 1 | 4 | Drift ≤ 10 cents/°C.
Availability 2026 (TS12) | 0.15 | 5 | 3 | 3 | 5 | 5 | CEM3340 cloned but stock erratic.
Cost (TS12) | 0.15 | 5 | 3 | 2 | 5 | 3 | Per-unit BOM cost impact.
PCB area (TS8) | 0.10 | 4 | 5 | 5 | 5 | 3 | Affects 8 HP form-factor.
Complexity / risk | 0.15 | 4 | 4 | 5 | 3 | 2 | Higher risk → longer schedule.
Σ weights (must = 1.00) | 1.00
Weighted total (out of 5) |  | 3.65 | 4.25 | 4.25 | 3.15 | 3.35
Rank |  | 3 | 1 | 1 | 5 | 4
Conclusion | The discrete NPN pair (Q1/Q2) ranks first on availability + cost and is acceptable on accuracy once a PTC tempco resistor (R5, 1 kΩ, +3300 ppm/°C) is placed in the emitter. It is adopted for the prototype, with a planned upgrade path to SSM2212 if tempco bench tests fail (TP-001).
Constraints / limitations | Matched-pair IC (SSM2212) scores slightly higher but costs ~4× more per unit and is becoming scarce. Tempco resistor assumed positive 3300 ppm/°C — verified against Vishay PTCEL datasheet [12].

Sheet: Choice-Tempco
Choice matrix — temperature-compensation strategy
Problem statement | How do we compensate the −2 mV/°C Vbe drift of the exponential pair so musical tuning is preserved?
Criterion | Weight | PTC tempco resistor in Q2 emitter (chosen) | Thermistor-compensated divider at U1 | Oven-stabilised BJT pair (TEC) | Software calibration via MCU | Rationale for weight
Drift (TS5) | 0.35 | 4 | 3 | 5 | 3 | Primary performance driver.
Cost (TS12) | 0.20 | 5 | 4 | 1 | 2 | Direct BOM cost.
Build complexity | 0.15 | 5 | 3 | 2 | 2 | Schedule risk.
Power consumption (TS11) | 0.15 | 5 | 5 | 1 | 3 | Total ≤ 0.72 W budget.
Reversibility / iteration | 0.15 | 5 | 4 | 2 | 3 | Can we pivot if it fails?
Σ weights (must = 1.00) | 1.00
Weighted total (out of 5) |  | 4.65 | 3.65 | 2.70 | 2.65
Rank |  | 1 | 2 | 3 | 4
Conclusion | PTC tempco resistor (R5, 1 kΩ at +3300 ppm/°C) placed in series with Q2 emitter gives the best cost-weighted performance and is trivially reversible. The design naturally upgrades to an SSM2212 on-die pair in revision v2.0 if the drift test (TP-001) exceeds 10 cents/°C.
Constraints / limitations | PTC tolerance (typ. ±5 %) introduces a residual tracking error of ~1 cent — inside the TS5 budget but a sensitivity that must be confirmed on the bench.

Sheet: Weights Rationale
Weight-allocation rationale across all choice matrices
Criterion family | Typical weight | Justification | Linked target spec
1 V/oct accuracy | 0.25 – 0.35 | Directly musical; player immediately notices >5 cent error. Highest weight wherever applicable. | TS2, TS5
Thermal drift | 0.15 – 0.20 | A VCO that drifts ruins live performance. Weighted high but below pitch accuracy because it can be partially mitigated by re-tuning. | TS5
Waveform linearity / THD | 0.15 | Defines timbre. Audible when THD > 1 % on a triangle. | TS6, TS7
Cost | 0.10 – 0.20 | Hobbyist market is price-sensitive — but we can trade £2 against a major performance gain. | TS12
Availability | 0.10 – 0.15 | 2024-2026 chip shortages (notably CEM3340 clones) make this a real risk. | TS12
Complexity / schedule | 0.10 – 0.15 | Affects project time management skill evidence (1.8) and risk (1.3). | TS8
Power / environment | 0.10 – 0.15 | RoHS + Eurorack rail budget. | TS10, TS11

Sheet: Assumptions
Stated design assumptions
ID | Assumption | Justification / source | Risk if invalid
A1 | Q1/Q2 are thermally coupled (shared heatsink / glued together) so their junction temperatures track within ±0.5 °C. | Art of Electronics §2.3.4 [13]; EE12001_DD_2425 Section 3 [2]. | Uncoupled pair drifts 2×; tempco resistor cannot correct it.
A2 | R5 (1 kΩ) is a PTC tempco resistor with +3300 ppm/°C, not an ordinary metal-film. | Vishay PTCEL-series datasheet [12]. | Standard resistor → uncompensated drift ≈ 0.3 % /°C.
A3 | Supply is sourced from a compliant Eurorack PSU with ≤ 50 mVpp ripple. | Doepfer A-100 service manual [10]. | Poor PSU rejection → pitch modulation at 100/120 Hz.
A4 | Ambient studio temperature 10–40 °C (not gigging in a desert). | Typical Eurorack use case. | Beyond range, tempco linearisation breaks.
A5 | No over-voltage on CV inputs beyond ±12 V (standard patch-cable compatible signals). | Doepfer A-100 §1.3. | Base-emitter junction of Q1/Q2 can reverse-break.
A6 | 2N3904 pair β-match to within 10 % after sort (typical from a 100-unit batch). | Analog Devices MT-077 tutorial [14]. | Asymmetric duty cycle; TS7 fails.
A7 | TL074 op-amps have sufficient slew-rate (13 V/µs) to drive 20 kHz at 10 Vpp. | Texas Instruments TL074 datasheet [15]: required SR = π·f·Vpp = 0.63 V/µs. | Above ~25 kHz, triangle becomes rounded.
A8 | VREF is mid-rail (0 V for ±12 V supply), generated by R17/R18 divider from GND. | Schematic inspection. | Asymmetric Schmitt thresholds → TS7 fails.

Sheet: References
References
[1] | Reid, G. (2000). Synth Secrets: The Voltage Controlled Oscillator. Sound on Sound, April issue.
[2] | University of Bath (2024). EE12001 Design & Development course notes, Year 1 feasibility-study skill template.
[3] | Doepfer Musikelektronik. A-100 Modular Synthesiser Technical Details. https://www.doepfer.de/a100_man/a100t_e.htm (accessed Apr 2026).
[4] | Korg Inc. (1982). MS-20 Service Manual — VCO temperature-stability section.
[5] | Pirkle, W. (2019). Designing Software Synthesizer Plug-Ins in C++ (2nd ed.), Focal Press. Chapter 4 (Waveform spectra).
[6] | British Standards Institution. BS EN 61010-1:2010+A1:2019 — Safety requirements for electrical equipment.
[7] | Mills, T. (2021). Adaptive music controllers for differently-abled musicians. Journal of the Audio Engineering Society 69(5).
[8] | European Parliament (2015). Directive 2015/863/EU (RoHS 3) on restriction of hazardous substances.
[9] | Thonk / Synthrotek retail price lists, VCO kits, Q1 2026.
[10] | Doepfer Musikelektronik. A-100 Standard — 10-pin power bus and panel dimensions.
[11] | British Standards Institution. BS EN 55032:2015+A11:2020 — Electromagnetic compatibility of multimedia equipment.
[12] | Vishay Draloric. PTCEL/PTCCL Silicon PTC Thermistors — datasheet 29058.
[13] | Horowitz, P. & Hill, W. (2015). The Art of Electronics (3rd ed.), Cambridge University Press.
[14] | Analog Devices Inc. MT-077 — Log Amps and Translinear Circuits, Rev. A, 2009.
[15] | Texas Instruments. TL074 Low-Noise JFET-Input Op-Amp datasheet, SLOS080N (rev. 2022).
[16] | Self, D. (2010). Small Signal Audio Design, Focal Press. Chapter 9 (Oscillators).
