sps80-SaiSingaravelan/Synthesiser-Project/SynthesizerProject_QMS/Operations/Project Plans/260304-Synthesizer-EEE-AdvancedProjectManagement-v1-00.docx

Design and Implementation of an Analogue Subtractive Synthesiser with Dual-Waveform VCO and Shared Envelope Modulation(kce27,…..)

Aims

The aim of this project is to design, prototype, build, and validate a functional analogue subtractive synthesiser using modular circuit blocks. The system will implement a voltage-controlled oscillator with saw and square outputs, a voltage-controlled filter, a voltage-controlled amplifier, and a shared ADSR envelope generator for both amplitude and filter modulation. The project applies analogue circuit theory, op-amp design, and structured testing methodology while developing project management, documentation, and practical prototyping skills.

Scope

This project includes circuit design, simulation, breadboard prototyping, hardware implementation, testing, and integration of the following modules: regulated power supply, VCO with saw core and square comparator stage, VCF, VCA, LFO, and a buffered ADSR envelope generator driving both VCF and VCA.

Each module will first be validated on a breadboard prior to permanent implementation on PCB. The scope includes schematic capture, component selection, calibration, oscilloscope-based validation, and system integration.

The project excludes digital control systems, MIDI interfacing, polyphony, pre-set memory, and commercial enclosure finishing. The synthesiser will operate as a monophonic analogue system powered by regulated supply rails.

Objectives

1. Develop project management documentation including a project management plan, time management schedule, quality management system (QMS), feasibility study and non-technical presentation by …… to ensure the synthesiser project is organised, achievable, and aligned with project constraints.
2. Simulate the VCO, VCF, VCA, and ADSR circuits using circuit simulation software prior to breadboard implementation, verifying expected waveform behaviour, voltage ranges, and control responses.
3. Design and successfully prototype the VCO, VCF, VCA, and ADSR circuits on breadboards by ……, verifying waveform integrity, voltage ranges, and modulation behaviour using oscilloscope measurements.
4. Construct and test a saw-core VCO with buffered saw and square outputs by ……., confirming waveform shape, amplitude stability, and frequency control.
5. Demonstrate that a buffered ADSR envelope can drive both the VCF cut-off and VCA control input without distortion or loading effects by ……
6. Integrate all validated modules into a complete signal chain by ….. and achieve stable audio output with measurable modulation response and acceptable noise performance.
7. Produce a technical report including breadboard test data, oscilloscope captures, calibration results, and final validation results prior to final portfolio submission.

Work Packages and Tasks

Work Package 1: Project Management and Documentation

Develop and maintain structured project management documentation to ensure the project is organised, feasible, and completed within the available timeframe.

Tasks:

- Produce the project management document including aims, scope, objectives, work packages, deliverables, and milestones.
- Develop Gantt Chart outlining the project schedule and key deadlines.
- Prepare a Quality Management System (QMS) outlining testing procedures and verification methods.
- Conduct a feasibility study to evaluate, technical, economic, and social factors affecting the project.
- Maintain documentation throughout the project and update it as progress is made.

Work Package 2: System Architecture and Specification

Define technical boundaries and prevent scope creep.

Tasks:

- Produce system block diagram and signal flow.
- Define voltage ranges for control and audio signals.
- Select circuit topologies for all modules.
- Simulate key subsystems.
- Finalise schematic for prototyping.

Work Package 3: Power Supply Design and Testing

Provide stable and low-noise supply rails.

Tasks:

- Design regulated supply rails.
- Assemble PSU on breadboard.
- Measure ripple and stability.
- Approve supply for subsystem testing.

Work Package 4: Breadboard Prototyping of Core Audio Modules

Validate analogue behaviour before permanent build.

Tasks:

- Prototype VCO on breadboard.
- Measure saw waveform linearity and frequency range.
- Implement square comparator and verify duty cycle.
- Prototype VCF and test cut-off sweep response.
- Prototype VCA and verify amplitude control.
- Prototype ADSR and verify envelope timing stages.
- Buffer ADSR output and test dual modulation paths.

Work Package 5: Permanent Implementation

Convert validated breadboard circuits into professionally manufactured printed circuit boards and verify correct operation after fabrication.

Tasks:

- Transfer validated schematics into OrCAD and assign appropriate component footprints.
- Design PCB layout following analogue best practice including grounding, decoupling, and signal separation.
- Perform DRC and peer review before generating fabrication files.
- Submit Gerber files for external PCB manufacture.
- Assemble fabricated PCBs and test performance against breadboard results.

Work Package 6: LFO and Modulation Integration

Implement additional modulation source.

Tasks:

- Design and prototype LFO on breadboard.
- Validate frequency range.
- Integrate modulation routing into system.
- Test pitch and filter modulation response.

Work Package 7: System Integration and Debugging

Combine modules into complete synthesiser.

Tasks:

- Connect signal chain VCO to VCF to VCA.
- Integrate envelope and LFO routing.
- Perform signal tracing using oscilloscope.
- Identify and resolve instability or noise issues.
- Optimise grounding layout.

Work Package 8: Final Validation and Documentation

Demonstrate measurable system performance.

Tasks:

- Capture oscilloscope waveforms.
- Measure modulation depth and response.
- Evaluate noise performance.
- Compile technical report with test data.

Milestones:

Project management documentation completed and approved (WP1)

All required management documents including the project management plan, time management schedule, QMS, and feasibility study are completed and reviewed before the technical implementation stages begin.

Approved system schematic (WP2)

All circuit diagrams are reviewed and confirmed to meet project scope and technical feasibility. Component values and topologies are fixed so breadboard prototyping can begin.

Verified stable power rails (WP3)

Output voltages meet design values under load with acceptable ripple and noise. The supply is considered reliable for analogue audio circuits.

Breadboard validation of VCO, VCF, VCA and envelope complete (WP4)

Each module operates independently with expected behaviour. Oscillator waveforms are stable, filter cutoff responds to control voltage, amplifier gain follows envelope input, and envelope ADSR timing stages function correctly.

Shared envelope successfully driving both VCF and VCA (WP4)

ADSR output controls amplitude and filter cut-off simultaneously without distortion or loading effects.

PCB design approved and submitted for manufacture (WP5)

Layout passes rule checks and peer review and fabrication files are successfully submitted.

Assembled PCBs validated (WP5)

Populated boards demonstrate equivalent electrical behaviour to breadboard prototypes.

LFO operational and modulation routing confirmed (WP6)

LFO produces stable low-frequency signals and successfully modulates pitch or filter cut-off.

Full signal chain operational VCO to VCF to VCA (WP7)

Audio flows through the entire signal chain with envelope shaping and modulation functioning correctly.

Final validation testing complete (WP8)

All waveform captures, voltage measurements, and modulation tests are completed and recorded.

Deliverables

Work Package 1: Project Management and Documentation

▪ Completed project management document defining the structure and organisation of the synthesiser project.

▪ Time management plan outlining key stages, deadlines, and task allocation.

▪ Quality Management System documentation defining testing and validation procedures.

▪ Feasibility study evaluating project feasibility and constraints.

Work Package 2: System Architecture and Specification

- Approved system block diagram defining signal flow between VCO, VCF, VCA, ADSR, LFO, and power supply.
- Completed and reviewed circuit schematics with defined voltage ranges and component values.
- Confirmed module specifications ready for breadboard prototyping.

### Work Package 3: Power Supply Design and Testing

### Constructed regulated supply rails on breadboard.

### Verified output voltages under load using multimeter and oscilloscope measurements.

### Confirmed acceptable ripple, stability, and grounding performance for analogue circuitry.

### Work Package 4: Breadboard Prototyping of Core Audio Modules

- Functional breadboard VCO producing stable saw waveform across defined frequency range.
- Verified square waveform with acceptable duty cycle.
- Tested VCF with measurable cut-off sweep and resonance response.
- Validated VCA with envelope-controlled amplitude shaping.
- Verified ADSR timing stages and confirmed buffered output driving both VCF and VCA without loading effects.

### Work Package 5: PCB Design and Fabrication

- Completed PCB layouts in OrCAD passing design rule checks and peer review.
- Generated and submitted fabrication files for external PCB manufacture.
- Assembled manufactured PCBs with verified electrical performance matching breadboard prototypes.

Work Package 6: LFO and Modulation Integration

- Constructed and validated low-frequency oscillator on breadboard.
- Confirmed frequency range suitable for modulation applications.
- Verified successful routing of LFO to VCO pitch and VCF cut-off inputs.

### Work Package 7: System Integration and Debugging

- Connected full signal chain from VCO to VCF to VCA.
- Integrated ADSR and LFO modulation paths.
- Confirmed stable end-to-end audio output with observable modulation effects.

### Work Package 8: Final Validation and Documentation

- Captured oscilloscope waveforms demonstrating correct oscillator, filter, and envelope behaviour.
- Measured modulation depth, frequency response, and stability performance.
- Completed final technical report with validation data and calibration notes.
