sps80-SaiSingaravelan/Synthesiser-Project/SynthesizerProject_QMS/Operations/Project Plans/260416-Synthesizer-EEE-AdvancedProjectManagement-v2-00.docx

Design and Implementation of a Monophonic Analogue Synthesiser with Dual-Waveform VCO and Shared Envelope Modulation (kce27, jm3767, eckl21, jf2280, sps80, yll201)

Aims

The aim of this project is to design and simulate a functional monophonic analogue synthesiser using modular circuit blocks. The system will implement a voltage-controlled oscillator with triangle and square outputs, a voltage-controlled filter, a voltage-controlled amplifier, and a shared ADSR envelope generator for both amplitude and filter modulation. The project applies analogue circuit theory, op-amp design, PCB design principles, and structured testing methodology while developing project management, documentation, and practical prototyping skills.

Scope
This project covers the design, simulation, verification, and PCB layout of a monophonic analogue synthesiser. The system includes a VCO, VCF, VCA, and ADSR envelope generator. The VCO produces triangle and square waveforms, the VCF shapes the signal’s harmonic content, the VCA controls output amplitude, and the ADSR provides modulation control. The project includes circuit simulation, verification against target specifications, system integration, and PCB design suitable for manufacture. It excludes physical construction, hardware testing, enclosure design, MIDI, polyphony, pre-set memory, and final product assembly to keep the scope achievable.

Objectives

1. Develop complete project management documentation, including aims, scope, objectives, Gantt chart, QMS, and feasibility study, by 10th March, ensuring all documents are structured, version-controlled, and aligned with defined project constraints.
2. Design and simulate the VCO/LFO, VCF, VCA, and ADSR circuits in LTspice by 20th March, ensuring correct waveform generation, voltage ranges within +/- 10% of targets, and stable modulation behaviour.
3. Construct and test a VCO with buffered triangle and square outputs operating across at least three octaves through simulation by 20th March, confirming waveform shape, amplitude stability, and frequency control.
4. Validate an ADSR envelope circuit by 22nd March that produces correct attack, decay, sustain, and release stages, and can drive both VCF and VCA inputs without distortion or loading effects.
5. Integrate all circuit modules into a complete simulated signal chain by 1st April, achieving stable output, observable modulation response, and noise levels within acceptable analogue design limits.
6. Produce a manufacturable PCB layout in KiCad or OrCAD by 5th April, ensuring correct component placement, routing, grounding, and successful completion of design rule checks with zero critical errors.
7. Complete a technical report before final submission, including simulation results, waveform analysis, validation data, and justification of design decisions, ensuring all sections meet academic and formatting requirements.

Work Packages and Tasks

Work Package 1: Project Management and Documentation

Develop and maintain structured project management documentation to ensure the project is organised, feasible, and completed within the available timeframe.

Tasks:

- Produce the project management document including aims, scope, objectives, work packages, deliverables, and milestones.
- Develop Gantt Chart outlining the project schedule and key deadlines.
- Prepare a Quality Management System (QMS) outlining testing procedures and verification methods.
- Conduct a feasibility study to evaluate, technical, economic, and social factors affecting the project.
- Maintain documentation throughout the project and update it as progress is made.

Work Package 2: System Architecture and Specification

Define technical boundaries and prevent scope creep.

Tasks:

- Produce system block diagram and signal flow.
- Define voltage ranges for control and audio signals.
- Select circuit topologies for all modules.
- Finalise schematic for prototyping.

Work Package 3: Circuit Simulation and Verification

Validate circuit designs using simulation tools to ensure compliance with target specifications prior to PCB implementation.

Tasks:

- Simulate individual modules (VCO, VCF, VCA, ADSR) using circuit simulation software.
- Analyse waveform outputs, frequency response, and control behaviour.
- Compare simulation results with target specifications.
- Refine circuit designs based on simulation results.
- Document simulation outputs and verification results.

Work Package 4: PCB Design for Manufacture

Convert validated simulated circuits into a manufacturable PCB design using OrCAD.

Tasks:

- Transfer final circuit schematics into OrCAD and assign footprints.
- Design PCB layout following analogue best practice and manufacturing guidelines.
- Perform DRC and peer review.
- Generate Gerber files ready for manufacture.

Work Package 5: Final Validation and Documentation

Document results and validate overall system performance against target specifications.

Tasks:

- Compile technical report with simulation data and results.
- Include annotated waveform outputs from simulations for all modules.
- Compare simulation results against target specifications and justify performance.
- Analyse system-level behaviour including modulation response and signal flow.
- Evaluate limitations of the design and identify potential improvements.
- Document PCB layout design decisions and justification of key design choices.
- Ensure all documentation is correctly formatted, referenced, and suitable for submission.

Milestones:

Project documentation and feasibility study completed (WP1)

All management documentation including project plan, Gantt chart, QMS, and feasibility study are completed and reviewed, ensuring the project is organised, feasible, and aligned with constraints before technical work begins.

System specification finalised (WP2)

System architecture, signal flow, and circuit schematics are fully defined and agreed upon, providing a clear and complete design ready for simulation.

Circuit simulations validated (WP3)

All modules demonstrate correct operation in simulation, with waveform behaviour, voltage levels, and modulation response meeting defined target specifications.

PCB design completed and verified (WP4)

PCB layout is finalised, passes design rule checks and peer review, and fabrication files are generated, ensuring the design is ready for manufacture.

Final validation and documentation complete (WP5)

All simulation results are analysed and documented, and the final report is completed with clear justification of design decisions, limitations, and overall system performance.

Deliverables

### Work Package 1: Project Management and Documentation

- Completed project management document including aims, scope, objectives, work packages, deliverables, and milestones.
- Developed Gantt chart outlining project schedule and key deadlines.
- Prepared Quality Management System (QMS) defining verification and testing methodology.
- Completed feasibility study evaluating technical, economic, and social factors affecting the project.

### Work Package 2: System Architecture and Specification

- Approved system block diagram defining signal flow between all synthesiser modules.
- Defined voltage ranges for control and audio signals. Selected and justified circuit topologies for VCO, VCF, VCA, and ADSR modules.
- Completed and finalised circuit schematics ready for simulation.

### Work Package 3: Circuit Simulation and Verification

- Completed simulations of VCO, VCF, VCA, and ADSR circuits.
- Verified waveform behaviour, frequency response, and modulation characteristics.
- Documented simulation results demonstrating compliance with target specifications.

### Work Package 4: PCB Design for Manufacture

### Completed PCB layouts in OrCAD following analogue design best practice.

### PCB designs passing design rule checks and peer review.

### Generated Gerber files suitable for PCB manufacture.

### Final PCB design ready for production.

### Work Package 5: Final Validation and Documentation

- Compiled technical report including simulation data, analysis, and results.
- Included annotated waveform outputs for all modules and system-level behaviour.
- Documented comparison between simulation results and target specifications.
- Evaluated design limitations and proposed improvements.
- Documented PCB design decisions and justification of layout choices.
