sps80-SaiSingaravelan/Synthesiser-Project/SynthesizerProject_QMS/Operations/Gantt Charts/260226-Synthesizerproject-Ganttchart-V1.pdf

## Monophonic Analogue Synthesiser (kce27, jm3767, eckl21, jf2280, sps80, yll201)

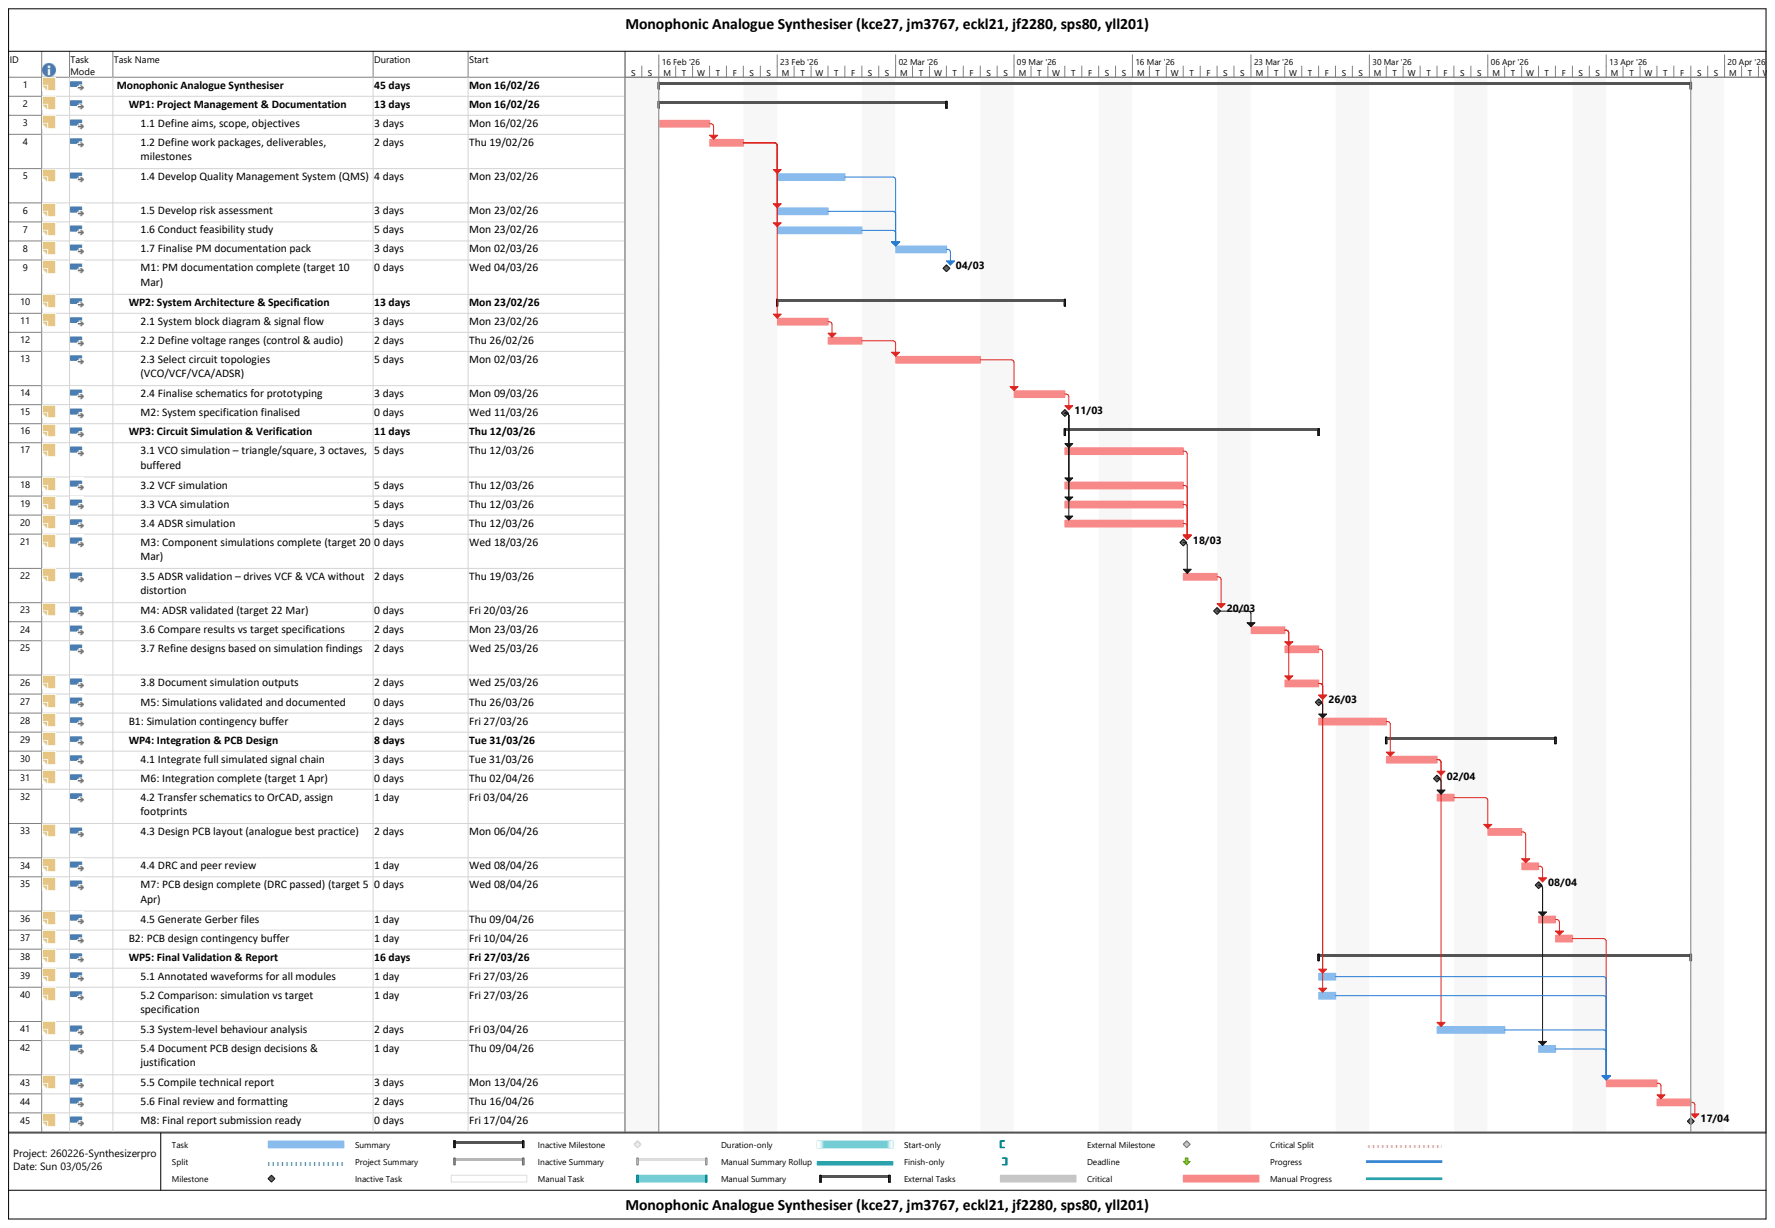
[picture p7: page 1]
2 days; Thu 19/03/26 23; M4: ADSR validated (target 22 Mar); 0 days; Fri 20/03/26 24; 3.6 Compare results vs target specifications; Mon 23/03/26 25; 3.7 Refine designs based on simulation findings; Wed 25/03/26 26; 3.8 Document simulation outputs; Wed 25/03/26 27; M5: Simulations validated and documented; Thu 26/03/26 28; B1: Simulation contingency buffer; Fri 27/03/26 29; WP4: Integration & PCB Design; 8 days; Tue 31/03/26 30; 4.1 Integrate full simulated signal chain; 3 days; Tue 31/03/26 31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

ID | Task Mode | | | | 16 Feb '26 | 23 Feb '26 | 02 Mar '26 | 09 Mar '26 | 16 Mar '26 | 23 Mar '26 | 30 Mar '26 | 06 Apr '26 | 13 Apr '26 | 20 Apr '26

Task Name Monophonic Analogue Synthesiser WP1: Project Management & Documentation 1.1 Define aims, scope, objectives 1.2 Define work packages, deliverables, | 45 days 13 days 3 days Duration | Start 1 Mon 16/02/26 2 Mon 16/02/26 3 Mon 16/02/26 4

1.4 Develop Quality Management System (QMS) 1.5 Develop risk assessment 1.6 Conduct feasibility study 1.7 Finalise PM documentation pack M1: PM documentation complete (target 10 | 2 days 4 days 3 days 5 days 3 days | Thu 19/02/26 5 Mon 23/02/26 6 Mon 23/02/26 7 Mon 23/02/26 8 Mon 02/03/26 9

milestones

WP2: System Architecture & Specification 2.1 System block diagram & signal flow 2.2 Define voltage ranges (control & audio) 2.3 Select circuit topologies | 0 days 13 days 3 days 2 days | Wed 04/03/26 10 Mon 23/02/26 11 Mon 23/02/26 12 Thu 26/02/26 13

Mar)

WP3: Circuit Simulation & Verification 2.4 Finalise schematics for prototyping M2: System specification finalised 3.1 VCO simulation – triangle/square, 3 octaves, | 5 days 3 days 0 days 11 days | Mon 02/03/26 14 Mon 09/03/26 15 Wed 11/03/26 16 Thu 12/03/26 17

(VCO/VCF/VCA/ADSR)

3.2 VCF simulation 3.3 VCA simulation 3.4 ADSR simulation M3: Component simulations complete (target 20 | 5 days 5 days | Thu 12/03/26 18 Thu 12/03/26 19 Thu 12/03/26 20 Thu 12/03/26 21

buffered

3.5 ADSR validation – drives VCF & VCA without Mar) | 0 days | Wed 18/03/26 22

distortion

4.3 Design PCB layout (analogue best practice) 4.4 DRC and peer review M7: PCB design complete (DRC passed) (target 5 | 1 day 2 days 1 day | Fri 03/04/26 33 Mon 06/04/26 34 Wed 08/04/26 35

footprints

B2: PCB design contingency buffer WP5: Final Validation & Report 4.5 Generate Gerber files 5.1 Annotated waveforms for all modules 5.2 Comparison: simulation vs target | 0 days 1 day 1 day 16 days 1 day | Wed 08/04/26 36 Thu 09/04/26 37 Fri 10/04/26 38 Fri 27/03/26 39 Fri 27/03/26 40

Apr)

Manual Summary Rollup
Manual Summary

Monophonic Analogue Synthesiser (kce27, jm3767, eckl21, jf2280, sps80, yll201)
