sps80-SaiSingaravelan/Synthesiser-Project/SynthesizerProject_QMS/Operations/Project Plans/260314-Synthesizerproject-SkillsMatrix-V1.xlsx

Skills Matrix: jf2280, eckl21, kce27, jm3767, sps80, yll201
Skill/Task | Jin | Ethan | Jindu | Jonathan | Sai | Alden
Project Management | 5 | 4 | 4 | 5 | 3 | 3
Circuit Simulation | 4 | 5 | 3 | 4 | 4 | 4
PCB Design | 4 | 5 | 3 | 3 | 3 | 5
Sustainability | 3 | 3 | 4 | 5 | 4 | 3
Technical Reporting | 5 | 4 | 4 | 3 | 4 | 4
 |  |  |  |  | Key:
 |  |  |  |  | 1-Basic Awareness
 |  |  |  |  | 5-Expert
