sps80-SaiSingaravelan/Synthesiser-Project/SynthesizerProject_QMS/260315-SynthesizerProject-VCFResonanceVerificationTestProtocol-V1.docx

jm3767, eckl21, jf2280, kce27, sps80, yll201

Date: 05/05/26

VCF Resonance Peak Verification Test Protocol

# 1. Scope

This protocol verifies that the VCF produces a clearly visible gain peak near the cut-off frequency when resonance is applied via the RV2 control. The resonance characteristic is essential for the expressive tonal character of the filter and is a key feature of the synthesiser design.

The test measures the peak gain at maximum RV2 setting using an AC frequency sweep and confirms that the peak meets the minimum +3 dB specification without triggering self-oscillation. It is executed on the VCF prototype circuit.

# 2. Specifications Under Test

Ref | Target Specification | Pass Criterion
TS1 | Resonance peak gain >= +3 dB (+/-1 dB) above passband level at maximum RV2 | Peak gain between +2 dB and +4 dB relative to passband
TS2 | Peak occurs near the cut-off frequency set by RV1 | Peak frequency within +/-20% of -3 dB cut-off frequency
TS3 | No self-oscillation at maximum RV2 setting | No sustained oscillation present when input signal is removed

# 3. Equipment Required

Ref | Item | Required Accuracy | Source
E1 | Digital oscilloscope (Tektronix TBS2104B or equivalent) | 100 MHz BW, 1 GS/s | University lab
E2 | Function generator (Keysight 33210A or equivalent) | 10 Hz - 100 kHz, amplitude accuracy +/-1% | University lab
E3 | VCF circuit prototype | - | Project prototype
E4 | Regulated DC power supply (+/-9 V) | +/-0.05% voltage regulation | University lab
E5 | Digital multimeter (Fluke 87V or equivalent) | AC voltage +/-0.5% of reading | University lab

# 4. Test Set-up

- Connect the VCF circuit to the regulated DC power supply (E4) and verify the supply rails at +9 V and -9 V before proceeding.
- Connect the function generator (E2) to the audio input (J2) of the VCF. Set the output to a 1 V peak-to-peak sine wave.
- Connect the oscilloscope probe (E1, x10 setting) to the output (J3) of the VCF, with ground clip to circuit ground.
- Set RV1 (cut-off frequency control) to a mid-range position (approximately 50% rotation) to set a reference cut-off frequency near 1 kHz.
- Set RV2 (resonance control) initially to minimum (fully counterclockwise) to establish the no-resonance baseline.

# 5. Test Procedure

- With RV2 at minimum, perform a frequency sweep from 100 Hz to 10 kHz in steps. Record the output amplitude at each step. This establishes the baseline frequency response and the passband reference level.
- Identify the cut-off frequency (fC) at this RV1 setting from the -3 dB point of the baseline response.
- Set RV2 to maximum (fully clockwise). Repeat the frequency sweep across the same frequency range.
- Identify the peak gain frequency and the peak amplitude. Calculate the peak gain in dB relative to the baseline passband level.
- Remove the input signal (set function generator output to 0 V). Observe the output on the oscilloscope for at least 5 seconds to confirm no sustained self-oscillation is present.
- Repeat the full measurement sequence at RV2 maximum three times. Record peak gain and peak frequency at each run.

# 6. Acceptance Criteria

All three specifications must be satisfied for the circuit to pass this test. A failure on any criterion requires root-cause analysis before the design may proceed.

Ref | Criterion | Outcome if Not Met
TS1 | Peak gain at RV2 maximum between +2 dB and +4 dB above passband | FAIL - root-cause analysis required
TS2 | Peak frequency within +/-20% of cut-off frequency fC | FAIL - root-cause analysis required
TS3 | No sustained oscillation at output when input removed | FAIL - root-cause analysis required
