sps80-SaiSingaravelan/Synthesiser-Project/SynthesizerProject_QMS/Quality documents/Feasibility Documents/260315-Synthesizerproject-ADSROutputVoltageVerificationTestProtocol-V2.docx

jm3767, eckl21, jf2280, kce27, sps80, yll201

Date: 15/03/26

ADSR Envelope Output Voltage Verification Test Protocol

# 1. Scope

This protocol verifies that the ADSR envelope generator produces the correct voltage levels during the attack and sustain phases. Accurate voltage levels are essential for reliable signal control in the synthesiser system.

The test measures the peak voltage reached during the attack phase and the steady-state voltage maintained during the sustain phase, comparing both against the design specifications. It is executed on the ADSR envelope generator prototype.

# 2. Specifications Under Test

Ref | Target Specification | Pass Criterion
TS1 | Peak voltage = 5.0 V +/- 5% (during attack phase) | Measured peak between 4.75 V and 5.25 V
TS2 | Sustain voltage = 50% of peak +/- 5% (design: 2.5 V) | Measured sustain between 2.375 V and 2.625 V

# 3. Equipment Required

Ref | Item | Required Accuracy | Source
E1 | Digital oscilloscope (Tektronix TBS2104B or equivalent) | 100 MHz BW, 1 GS/s | University lab
E2 | Digital multimeter (Fluke 87V or equivalent) | DC voltage +/-0.05% of reading | University lab
E3 | ADSR envelope generator circuit | - | Project prototype
E4 | Regulated DC power supply (+/-12 V) | +/-0.05% voltage regulation | University lab
E5 | Gate trigger signal source (function generator) | 0-5 V logic level | University lab

# 4. Test Set-up

1. Connect the ADSR circuit to the regulated DC power supply (E4) and verify the supply rails at +12 V and -12 V before proceeding.
2. Connect the oscilloscope probe (E1, x10 setting) to the envelope output of the circuit, with the ground clip connected to the circuit ground.
3. Connect the digital multimeter (E2) in parallel across the envelope output to provide a stable DC reading during the sustain phase.
4. Connect the gate trigger source (E5) to the GATE input of the ADSR circuit. Configure for a 5 V logic-level square wave with sufficient on-time to allow the envelope to reach and hold the sustain level.
5. Configure the oscilloscope to capture the full attack ramp and sustain plateau. Trigger on the rising edge of the gate signal.

# 5. Test Procedure

6. Apply a gate signal from E5 to trigger the ADSR circuit. Hold the gate high for at least 500 ms to allow the sustain voltage to fully stabilise.
7. Observe the envelope waveform on E1. Confirm the attack ramp transitions smoothly from 0 V to the peak with no overshoot or instability.
8. Record the maximum voltage reached during the attack phase (peak voltage) using the oscilloscope cursor measurement.
9. Once the envelope has settled at the sustain level, record the sustain voltage from both E1 (waveform) and E2 (multimeter).
10. Remove the gate signal and allow the envelope to return to 0 V before the next measurement.
11. Repeat the full sequence three times. Record all measured values and calculate the mean and percentage deviation from the design target for each parameter.

# 6. Acceptance Criteria

Both voltage specifications must be satisfied for the circuit to pass this test. A failure on either criterion requires root-cause analysis before the design may proceed.

Ref | Criterion | Outcome if Not Met
TS1 | Measured peak voltage within +/-5% of 5.0 V (i.e. 4.75 V - 5.25 V) | FAIL - root-cause analysis required
TS2 | Measured sustain voltage within +/-5% of 2.5 V (i.e. 2.375 V - 2.625 V) | FAIL - root-cause analysis required
