sps80-SaiSingaravelan/Synthesiser-Project/SynthesizerProject_QMS/Quality documents/Feasibility Documents/260315-Synthesizerproject-ADSRTimingVerificationTestProtocol-V2.docx

jm3767, eckl21, jf2280, kce27, sps80, yll201

Date: 15/03/26

ADSR Envelope Timing Verification Test Protocol

# 1. Scope

This protocol verifies that the ADSR envelope generator produces timing characteristics that meet the design specifications. The test measures the duration of each envelope stage - Attack, Decay, Sustain, and Release - to confirm the circuit operates within the acceptable tolerance limits defined in the system specifications.

# 2. Specifications Under Test

Ref | Target Specification | Pass Criterion
TS1 | Attack time = 100 ms +/- 10% | Measured attack between 90 ms and 110 ms
TS2 | Decay time = 200 ms +/- 10% | Measured decay between 180 ms and 220 ms
TS3 | Release time = 300 ms +/- 10% | Measured release between 270 ms and 330 ms
TS4 | Sustain voltage stable while gate is held high | Voltage variation < +/-5% of set sustain level

# 3. Equipment Required

Ref | Item | Required Accuracy | Source
E1 | Digital oscilloscope (Tektronix TBS2104B or equivalent) | +/-0.5 ms timing resolution, 100 MHz BW | University lab
E2 | Gate trigger signal source (function generator) | 0-5 V logic level | University lab
E3 | ADSR envelope generator circuit | - | Project prototype
E4 | Regulated DC power supply (+/-12 V) | +/-0.05% voltage regulation | University lab
E5 | Oscilloscope probes (x10 passive) | 100 MHz BW | University lab

# 4. Test Set-up

1. Connect the ADSR circuit to the regulated DC power supply (E4) and verify the supply rails at +12 V and -12 V before proceeding.
2. Connect the oscilloscope probe (E5) to the envelope output of the circuit. Use the x10 probe setting with the ground clip connected to the circuit ground.
3. Connect the gate trigger source (E2) to the GATE input of the ADSR circuit. Configure it to produce a 5 V logic-level square wave with sufficient on-time to capture the full envelope.
4. Configure the oscilloscope (E1) to capture the full ADSR envelope waveform. Set the time base to show at least 800 ms and the voltage range to show 0-5 V clearly.
5. Set the oscilloscope trigger to the rising edge of the gate signal so the full envelope cycle is consistently captured on each trigger.

# 5. Test Procedure

6. Apply a gate signal from E2 to trigger the envelope generator. Hold the gate high for at least 500 ms to ensure the sustain stage is clearly visible on the oscilloscope.
7. Observe the waveform on E1. Confirm the expected exponential attack, decay, and release transitions are visible and free from artefacts or clipping.
8. Measure the attack time: the elapsed time from the onset of the gate (0 V) to the point where the envelope reaches its peak voltage.
9. Measure the decay time: the elapsed time from the peak voltage to the stable sustain voltage level.
10. While the gate remains high, observe the sustain voltage over a 200 ms window and note any variation from the stable level.
11. Remove the gate signal and measure the release time: the elapsed time from gate removal until the envelope output returns to 0 V.
12. Repeat the full measurement sequence three times. Record all values and calculate the mean for each stage.

# 6. Acceptance Criteria

All four specifications must be satisfied for the circuit to pass this test. A failure on any single criterion requires root-cause analysis before the design may proceed.

Ref | Criterion | Outcome if Not Met
TS1 | Measured attack time within +/-10% of 100 ms target | FAIL - root-cause analysis required
TS2 | Measured decay time within +/-10% of 200 ms target | FAIL - root-cause analysis required
TS3 | Measured release time within +/-10% of 300 ms target | FAIL - root-cause analysis required
TS4 | Sustain voltage variation < +/-5% during gate-hold period | FAIL - root-cause analysis required
