sps80-SaiSingaravelan/Synthesiser-Project/SynthesizerProject_QMS/Quality documents/Feasibility Documents/260315-Synthesizerproject-ADSRVerificationTestResults-V1.docx

ADSR Envelope Verification Test Results:

Test 1 – ADSR Envelope Timing Verification

Results

The ADSR envelope waveform was captured using an oscilloscope. The following timing values were measured:

Parameter | Target Value | Measured Value
Attack Time | 100 ms | 105 ms
Decay Time | 200 ms | 210 ms
Release Time | 300 ms | 295 ms

All measured values fall within the + or - 10% tolerance range specified in the verification protocol.

Explanation

The results demonstrate that the timing characteristics of the envelope generator are consistent with the system design. The small deviations observed are within acceptable engineering tolerances and may result from component tolerances such as resistor and capacitor variations.

Conclusion

The ADSR envelope generator successfully meets the timing performance requirements defined in the system specifications. The circuit demonstrates reliable operation and repeatable behaviour across multiple test runs.

Test 2 – Envelope Output Voltage Verification

Results

Voltage measurements were recorded using a digital multimeter and oscilloscope.

Parameter | Target Value | Measured Value
Peak Voltage | 5.0 V | 4.92 V
Sustain Voltage (50%) | 2.5 V | 2.48 V

All measured voltages are within the + or - 5% tolerance limit defined in the test protocol.

Explanation

The measured peak voltage is slightly below the target value but remains within the acceptable tolerance range. The sustain voltage closely matches the expected value, indicating correct operation of the sustain control stage.

Conclusion

The ADSR envelope generator meets the required voltage specifications. The output voltage levels are stable and consistent, confirming that the circuit performs as intended.

jm3767,eckl21,jf2280,kce27,sps80,yll201
