sps80-SaiSingaravelan/Synthesiser-Project/SynthesizerProject_QMS/Quality documents/Feasibility Documents/260315-Synthesizerproject-Test1ADSREnvelopeTimingVerification-V3.docx

jm3767, eckl21, jf2280, kce27, sps80, yll201

Date: 15/03/26

ADSR Envelope Verification Test Results - Test 1: ADSR Envelope Timing Verification

# Results

The ADSR envelope waveform was captured using a digital oscilloscope, allowing accurate cursor measurement of the timing associated with each stage. All three timing measurements were repeated three times; the values below represent the mean. Measured values are compared directly with the target design specifications.

Parameter | Target Value | Measured Value (mean) | Error vs Target
Attack Time | 100 ms | 105 ms | +5 ms (+5.0%)
Decay Time | 200 ms | 210 ms | +10 ms (+5.0%)
Release Time | 300 ms | 295 ms | -5 ms (-1.7%)

All measured values fall within the +/-10% tolerance range specified in the verification protocol. The waveform observed on the oscilloscope displayed the expected exponential charging and discharging behaviour typical of an ADSR envelope generator, with no observed discontinuities or distortion across all three repeated runs.

# Explanation

The results demonstrate that the timing performance of the ADSR envelope generator is closely aligned with the intended design. The small variations between the target and measured values are expected in analogue circuits and are primarily due to component tolerances. Resistors and capacitors used in the timing network typically carry tolerances of +/-5% or higher, which directly influence the RC time constants that govern the attack, decay, and release durations.

The slightly longer attack and decay times suggest that the effective resistance or capacitance in those stages may be marginally higher than their nominal values, while the slightly shorter release time results from the opposite effect. Both observations are consistent with normal component variation.

Environmental factors such as ambient temperature and supply voltage fluctuations can also influence analogue circuit behaviour, but their contribution is small at the conditions experienced during this test. The consistency of results across the three repeated measurements confirms circuit stability and repeatability throughout the test session.

# Deviations and Observations

No unexpected deviations were recorded during testing. The waveform shape remained consistent and free from distortion or instability across all three measurement runs.

Component tolerances were the dominant source of the small timing offsets observed; no corrective action is required as all values are well within the +/-10% acceptance window.

The sustain voltage was observed to be stable throughout the gate-hold period, with no noticeable variation detected on the oscilloscope.

# Overall Verification Status

Ref | Description | Criterion | Status
TS1 | Attack time | 100 ms +/- 10% to [90 ms, 110 ms] | PASS
TS2 | Decay time | 200 ms +/- 10% to [180 ms, 220 ms] | PASS
TS3 | Release time | 300 ms +/- 10% to [270 ms, 330 ms] | PASS
TS4 | Sustain stability | Variation < +/-5% during gate hold | PASS

# Conclusion

The ADSR envelope generator successfully meets the timing requirements defined in the system specifications. All four measured parameters fall within the acceptable tolerance range, confirming that the circuit performs as expected.

The minor deviations observed are typical of analogue systems and do not significantly affect functionality. The circuit demonstrates reliable and repeatable behaviour, making it suitable for use in the synthesiser system. This test confirms that the envelope generator can accurately control the timing of signal amplitude, which is essential for shaping sound in audio applications.
