sps80-SaiSingaravelan/Synthesiser-Project/SynthesizerProject_QMS/Quality documents/Feasibility Documents/260315-Synthesizerproject-Test2EnvelopeOutputVoltageVerification-V3.docx

jm3767, eckl21, jf2280, kce27, sps80, yll201

Date: 15/03/26

ADSR Envelope Verification Test Results - Test 2: Envelope Output Voltage Verification

# Results

Voltage measurements were taken using both a digital multimeter and an oscilloscope to ensure accuracy and to observe the waveform characteristics. Each measurement was repeated three times; the values below represent the mean. Measured values are compared with the expected design targets.

Parameter | Target Value | Measured Value (mean) | Error vs Target
Peak Voltage | 5.0 V | 4.92 V | -0.08 V (-1.6%)
Sustain Voltage (50% level) | 2.5 V | 2.48 V | -0.02 V (-0.8%)

All measured voltages are within the +/-5% tolerance limit defined in the test protocol. The oscilloscope confirmed smooth transitions between voltage levels, with no visible instability or distortion. The sustain voltage remained stable throughout the gate-hold period across all three repeated runs.

# Explanation

The measured peak voltage is 0.08 V below the 5.0 V design target - a deviation of 1.6%, well within the +/-5% pass window. This small offset is consistent with the non-ideal characteristics of analogue op-amp circuits, including minor forward voltage drops and finite output impedance. No corrective action is required.

The sustain voltage of 2.48 V closely matches the expected 50% level of 2.5 V, confirming that the voltage-division mechanism responsible for maintaining the sustain stage is functioning correctly. The close agreement between the oscilloscope and multimeter readings validates the measurement approach and rules out any systematic instrument error.

In practical analogue systems, variations of this magnitude are unavoidable due to component tolerances, internal resistances, and loading effects. During testing, the output remained consistent without noticeable fluctuation, indicating that the circuit design is robust and not significantly affected by noise or supply-rail variation.

# Deviations and Observations

No unexpected deviations were recorded. Waveform transitions were smooth and free from ringing or overshoot across all three measurement runs.

The small negative offset in peak voltage is attributed to op-amp output saturation characteristics and is within expected limits for this circuit topology.

Supply voltage and ambient temperature remained stable throughout the test session; no corrections to the measurements were required.

# Overall Verification Status

Ref | Description | Criterion | Status
TS1 | Peak voltage | 5.0 V +/- 5% to [4.75 V, 5.25 V] | PASS
TS2 | Sustain voltage | 2.5 V +/- 5% to [2.375 V, 2.625 V] | PASS

# Conclusion

The ADSR envelope generator meets the required voltage specifications, with both measured values falling within the +/-5% acceptance tolerance. The circuit produces stable and accurate voltage levels for both the peak and sustain stages, confirming correct operation.

These results demonstrate that the envelope generator is capable of reliably controlling signal amplitude, which is critical for consistent audio performance in the synthesiser system. The minor deviations observed are negligible and do not impact overall functionality. The circuit is therefore considered suitable for integration into the final design.
