sps80-SaiSingaravelan/Synthesiser-Project/SynthesizerProject_QMS/Quality documents/Feasibility Documents/260315-Synthesizerproject-VCFCutOffVerificationTestProtocol-V1.docx

VCF Cut-off Frequency Verification Test Protocol

Date: 15/03/26

1. Purpose

The purpose of this test is to verify that the Voltage Controlled Filter (VCF) achieves a controllable cut-off frequency within the specified range of 100 Hz to 5 kHz ±10%, as defined in the Design and Development (D&D) matrix.

2. Test Objectives

This test verifies the following requirements:

- N1.1 – The synthesiser must shape the harmonic content of the VCO output.
- S1.1 – Cut-off frequency adjustable from 100 Hz to 5 kHz ±10%.
- S1.2 – The filter must operate over at least three octaves of the audible range.

3. Equipment Required

- LTspice simulation environment
- VCF LTspice circuit file
- Square wave input source (±5 V)
- LTspice waveform viewer

4. Test Setup

1. The VCF circuit is loaded into LTspice.
2. A square wave input signal of approximately ±5 V is applied to the input of the filter.
3. The output node is connected to the LTspice waveform viewer.
4. The circuit is powered using the specified supply rails (e.g. ±9 V or ±12 V).

5. Test Procedure

1. Set the cut-off control to its minimum position and run the simulation.
2. Perform an AC sweep and determine the -3 dB cut-off frequency.
3. Record the measured value.
4. Repeat the procedure for the mid position of the control.
5. Repeat again for the maximum position of the control.

6. Acceptance Criteria

- The minimum cut-off frequency must be at least 100 Hz within ±10%.
- The maximum cut-off frequency must reach at least 5 kHz within ±10%.
- The filter must demonstrate a usable range covering at least three octaves.

8. Verification Method

AC analysis in LTspice is used to determine the -3 dB cut-off frequency.

10. Notes

- Ensure that the input amplitude remains constant for all tests.
- Use a logarithmic frequency scale when analysing the response.

jm3767, eckl21, jf2280, kce27, sps80, yll201
