sps80-SaiSingaravelan/Synthesiser-Project/SynthesizerProject_QMS/Quality documents/Feasibility Documents/260315-Synthesizerproject-VCFCutoffVerificationTestResults-V1.docx

VCF Cut-off Frequency Verification Results

Date: 15/03/26

1. Purpose

The purpose of this document is to present the results of the cut-off frequency verification test and determine whether the VCF meets the specified performance requirements.

2. Related Protocol

VCF Cut-off Frequency Verification Test Protocol

3. Test Summary

The VCF was simulated in LTspice using a square wave input of approximately ±5 V.

An AC sweep was performed to determine the -3 dB cut-off frequency at different control settings.

4. Results

Control Setting | Measured Cut-off Frequency (Hz) | Required Range | Pass/Fail
Minimum | 112Hz | ≥ 100 Hz ±10% | PASS
Mid | 648 Hz | Within specified range | PASS
Maximum | 4.82 kHz | ≥ 5 kHz ±10% | PASS

5. Analysis

The minimum measured cut-off frequency of 112 Hz is within the acceptable tolerance of the 100 Hz target. The maximum measured cut-off frequency of 4.82 kHz is sufficiently close to the specified 5 kHz target and demonstrates that the filter covers the required operating range. The mid-setting result of 648 Hz confirms continuous control across the range.

6. Verification Outcome

- Minimum cut-off requirement: PASS / FAIL
- Maximum cut-off requirement: PASS / FAIL
- Frequency range requirement (≥ 3 octaves): PASS / FAIL

7. Conclusion

The VCF cut-off frequency verification test is considered PASS.

The measured minimum cut-off frequency of 112 Hz satisfies the requirement of 100 Hz ±10%, and the maximum cut-off frequency of 4.82 kHz is sufficiently close to the specified 5 kHz target.

The results demonstrate that the filter provides a continuous and controllable frequency range exceeding three octaves, meeting the performance requirements defined in the D&D matrix.

8. Notes

Potential sources of error include simulation resolution, component tolerances, or incorrect parameter settings.

jm3767, eckl21, jf2280, kce27, sps80, yll201
