sps80-SaiSingaravelan/Synthesiser-Project/SynthesizerProject_QMS/Quality documents/Feasibility Documents/260315-Synthesizerproject-VCFResonanceVerificationTestProtocol-V1.docx

VCF Resonance Verification Test Protocol

Date: 15/03/26

1. Purpose

The purpose of this test is to verify that the VCF provides adjustable resonance and produces a measurable peak near the cut-off frequency in accordance with the D&D specification.

2. Test Objective

This test verifies the following requirements:

- N3 – The filter should provide resonance to make the sound more characterful.
- S3 – A peak magnitude of at least +3 dB ±1 dB near the cut-off frequency.

3. Equipment Required

- LTspice simulation environment
- VCF LTspice circuit file
- AC analysis tool in LTspice

4. Test Setup

1. The VCF circuit is configured in LTspice.
2. An AC sweep input signal is applied to the filter.
3. The output is monitored using the frequency response plot.

5. Test Procedure

1. Set the resonance control to its minimum position and perform an AC sweep.
2. Record the baseline frequency response.
3. Increase the resonance control and repeat the AC sweep.
4. Observe and measure the peak gain near the cut-off frequency.
5. Repeat the process for maximum resonance.

6. Acceptance Criteria

- The resonance peak must reach at least +3 dB within a tolerance of ±1 dB.
- The resonance must be smoothly adjustable using the control.
- The system must remain stable without unwanted oscillation during normal operation.

8. Verification Method

Frequency response analysis using LTspice AC sweep.

10. Notes

- Ensure consistent input signal conditions during all tests.
- Avoid excessive resonance settings that may introduce clipping or instability.

jm3767, eckl21, jf2280, kce27, sps80, yll201
