sps80-SaiSingaravelan/Synthesiser-Project/SynthesizerProject_QMS/Quality documents/Feasibility Documents/260428-Synthesizerproject-EEE-VCOFrequencyTuningTestProtocol-v1-01.docx

Test Protocol — Frequency-Tuning Accuracy

April 2026

Scope

This protocol verifies that the prototype VCO exhibits the correct 1 V/octave tracking behaviour over the full audio band and that its pitch drift with ambient temperature is within the musical tolerance defined in the Feasibility Study (FS-001). It is executed on the single breadboarded prototype designated 'VCO-001'.

Important — Test environment: VCO-001 is built on a solderless breadboard; it is NOT yet a finished module. Inputs (KEY, TUNE, LFO) and outputs (TRI, SQR) are wired to dedicated rows on the breadboard rather than to 3.5 mm panel jacks; the TUNE control is a 10 kΩ multi-turn cermet trimmer breadboarded next to U1 (in the final module this becomes a panel pot). Power is supplied from a bench PSU via twisted-pair flying leads, not a Eurorack rack bus. As a result, breadboard parasitic capacitance and contact resistance are present and may slightly degrade absolute readings versus a finished PCB build.

Specifications Under Test

Ref | Target spec | Pass criterion
TS2 | 1 V/oct tracking error over 5 octaves ≤ ±5 cents | Max |error| ≤ 5 cents across ≥ 5 octaves of sweep
TS3 | Temperature-induced drift ≤ 10 cents/°C over 0 – 40 °C | |Δpitch| ≤ 10 cents per 1 °C of ambient change at A=440 Hz reference

Equipment

Ref | Item | Required accuracy | Source
E1 | Precision DC source (Keithley 2231A or equivalent) | ± 1 mV at 10 V FS | University lab
E2 | Frequency counter, Rigol DG4162 reference or equivalent | ± 0.1 Hz at audio | University lab
E3 | Environmental chamber, Binder MK-53 or equivalent | 0 – 40 °C ± 0.2 °C | University lab
E4 | True-RMS multimeter (Fluke 87V) | DC V ± 0.05 % | University lab
E5 | Oscilloscope, Tektronix TBS2104B | 100 MHz BW, 1 GS/s | University lab
E6 | Regulated ±12 V bench PSU | 1 A per rail | University lab

Set-up

- Power the breadboard from E6: clip +12 V to the breadboard's red rail and −12 V to the blue rail using twisted-pair flying leads to minimise loop area; verify < 50 mV ripple at the supply rows of U1, U2 and U5 with E5.
- Tie the TUNE and LFO input rows on the breadboard to the 0 V rail with short jumper wires (these inputs are not exercised in TP-001).
- Connect E1 to the KEY input row via banana-to-flying-lead, with the precision-source ground returned to the same 0 V rail used by the breadboard supply (single-point ground to keep CV referenced cleanly).
- Connect E2 (frequency counter) to the SQR output row of U5, using a hook-clip probe and a short ground lead clipped to the adjacent 0 V rail; SQR is preferred over TRI for the counter because the rail-to-rail edges trigger the counter reliably.
- Connect channel 1 of E5 to the TRI output (output of integrator U2 / buffered through U6 if wired) for visual confirmation of waveform shape and absence of clipping during the sweep.
- Place the breadboard, complete with bench PSU clip-leads, inside E3 (environmental chamber) and route the flying leads through the chamber's cable port; tape a K-type thermocouple to the body of the expo-pair transistors Q1/Q2; allow 30 min equilibration at 25 °C before starting.

Procedure — 1 V/octave tracking (TS2)

- Step 1. Trim the breadboarded TUNE trimmer for f_out = 55.000 Hz (MIDI A1) at KEY = 1.000 V.
- Step 2. Step KEY from 1.000 V to 6.000 V in 1.000 V increments (6 octaves, 7 points). Use E1 in source mode with sense leads on the same row as the input op-amp pin to remove flying-lead voltage drop.
- Step 3. At each step, wait 5 s for settle (longer settle than a PCB build because of breadboard thermal mass), then log f_out from E2 three times and record the mean.
- Step 4. Compute the pitch in cents relative to the 1 V reading: cents = 1200 · log₂(f/f₁).
- Step 5. Compute the tracking error = measured cents − expected cents (N × 1200).
- Step 6. Record the maximum |error| across the sweep and compare to the TS2 pass criterion.

Procedure — Temperature drift (TS3)

- Step 1. Set KEY = 3.000 V; trim the breadboarded TUNE trimmer for f_out = 440.000 Hz at 25 °C (reference).
- Step 2. Ramp E3 from 25 °C → 0 °C in 5 °C steps, holding each step for 15 min so the breadboard, transistors and PTC resistor reach equilibrium (the breadboard plastic adds thermal lag relative to a PCB).
- Step 3. At each step, log f_out and compute Δpitch in cents relative to 440 Hz.
- Step 4. Return to 25 °C, verify ≤ 5 cents residual drift (residual indicates thermal hysteresis from the breadboard), then ramp to 40 °C in 5 °C steps.
- Step 5. Plot Δpitch vs temperature; report slope in cents/°C and compare to TS3 pass criterion.

Recorded Data

Recorded data from execution of the protocol on the breadboarded prototype VCO-001, ambient 22.8 °C at the start of test, supply ±12.02 V / ±11.98 V from bench PSU. The 1 V/octave sweep is given first, followed by the temperature-drift sweep. Inputs and outputs were probed directly on the breadboard rows, so a small amount of additional drift (versus a finished PCB build) is expected and was accommodated by the PASS margin.

1 V/octave tracking (TS2):

Step | KEY (V) | Expected f (Hz) | Measured f (Hz) | Cents (rel. step 1) | Error (cents)
1 | 1.000 | 55.00 | 55.02 | 0 | 0
2 | 2.000 | 110.00 | 110.11 | +1202 | +2
3 | 3.000 | 220.00 | 220.09 | +2401 | +1
4 | 4.000 | 440.00 | 439.73 | +3599 | −1
5 | 5.000 | 880.00 | 878.96 | +4798 | −2
6 | 6.000 | 1760.00 | 1756.55 | +5997 | −3

Max |error| = 3 cents across 6 octaves; max |error| = 2 cents across the 5-octave window required by TS2. PASS.

Temperature drift (TS3):

T (°C) | Reference f (Hz) | Measured f (Hz) | Δpitch (cents) | Notes
0 | 440.00 | 434.11 | −23.3
5 | 440.00 | 435.24 | −18.9
10 | 440.00 | 436.48 | −14.0
15 | 440.00 | 437.82 | −8.6
20 | 440.00 | 438.95 | −4.1
25 | 440.00 | 440.00 | 0.0 | Reference
30 | 440.00 | 441.10 | +4.3
35 | 440.00 | 442.25 | +8.8
40 | 440.00 | 443.45 | +13.5

Linear fit: slope ≈ 0.92 cents/°C in the 20 – 30 °C window; worst-case slope 1.10 cents/°C (0 – 5 °C window). Both well inside the TS3 limit of 10 cents/°C. PASS.

Acceptance Criteria

- TS2 (1 V/octave): max |error| ≤ 5 cents across ≥ 5 octaves → PASS.
- TS3 (thermal drift): |slope| ≤ 10 cents/°C across 0 – 40 °C → PASS.
- A FAIL on either criterion triggers root-cause analysis and a design-change request, logged against the Change Log of FS-001.

jm3767, eckl21, jf2280, kce27, sps80, yll201
