sps80-SaiSingaravelan/Synthesiser-Project/SynthesizerProject_QMS/Quality documents/Feasibility Documents/260428-Synthesizerproject-EEE-VCOTestResults-v1-01.docx

Test Results — VCO-001 Prototype

April 2026

Summary

This report compiles the results of the two verification test protocols TP-001 and TP-002 executed on prototype VCO-001. Results are representative of a single hand-built unit, measured at ambient 22.8 °C in the Bath Electronics Teaching Lab on the date shown above. All readings are compared against the acceptance criteria stated in each protocol.

Unit Under Test

Attribute | Value
UUT designation | VCO-001
Build revision | A
Matched pair Vbe (Q1, Q2) at 25 °C | +0.63 mV
PTC resistor | 2.2 kΩ, +3300 ppm/°C, Weidmann-type
Supply used | ±12.02 V / ±11.98 V
Ambient during test | 22.8 °C

Results — TP-001 Frequency-Tuning Accuracy

1 V/octave tracking

Step | KEY (V) | Expected f (Hz) | Measured f (Hz) | Cents (rel. step 1) | Error (cents)
1 | 1.000 | 55.00 | 55.02 | 0 | 0
2 | 2.000 | 110.00 | 110.11 | 1202 | +2
3 | 3.000 | 220.00 | 220.09 | 2401 | +1
4 | 4.000 | 440.00 | 439.73 | 3599 | −1
5 | 5.000 | 880.00 | 878.96 | 4798 | −2
6 | 6.000 | 1760.00 | 1756.55 | 5997 | −3

Max |error| = 3 cents over 5 octaves (rows 1 – 6 span 6 octaves, the 5-octave window rows 1 – 5 shows max |error| = 2 cents). TS2 pass criterion is ≤ 5 cents — PASS.

Temperature drift

T (°C) | Reference f (Hz) | Measured f (Hz) | Δpitch (cents) | Notes
0 | 440.00 | 434.11 | −23.3
5 | 440.00 | 435.24 | −18.9
10 | 440.00 | 436.48 | −14.0
15 | 440.00 | 437.82 | −8.6
20 | 440.00 | 438.95 | −4.1
25 | 440.00 | 440.00 | 0.0 | Reference
30 | 440.00 | 441.10 | +4.3
35 | 440.00 | 442.25 | +8.8
40 | 440.00 | 443.45 | +13.5

Linear fit: slope ≈ 0.92 cents/°C (20 – 30 °C window); worst-case slope 1.10 cents/°C (0 – 5 °C window). TS3 criterion ≤ 10 cents/°C — PASS.

Results — TP-002 Waveform Quality

Target f (Hz) | Measured f (Hz) | THD (%) | Duty (%) | Notes
100 | 100.04 | 0.41 | 50.3 | Clean
1 000 | 1 000.17 | 0.52 | 50.1 | Clean
10 000 | 10 002.3 | 0.89 | 49.6 | Small ringing on SQR edges

TS4a: highest THD = 0.89 % at 10 kHz; criterion ≤ 1.0 % — PASS. TS4b: duty-cycle range 49.6 – 50.3 %; criterion 48 – 52 % — PASS.

Overall Verification Status

Spec | Description | Criterion | Measured | Status
TS2 | 1 V/oct tracking | ≤ 5 cents / 5 oct | 2 cents / 5 oct | PASS
TS3 | Thermal drift | ≤ 10 cents/°C | ≤ 1.10 cents/°C | PASS
TS4a | Triangle THD | ≤ 1.0 % | 0.89 % (worst case) | PASS
TS4b | Square duty | 50 % ± 2 % | 49.6 – 50.3 % | PASS

All four target specifications covered by the two protocols are met by VCO-001. No design changes are required before the next review.

Deviations and Observations

- A small amount of ringing was observed on the SQR output edges at 10 kHz; the ringing amplitude is within the ±0.3 V noise budget and does not affect duty measurement.
- The PTC resistor was bonded with thermal epoxy — cure time (24 h) must be respected in the build instructions to avoid early-life drift.
- Ambient temperature during test was 22.8 °C, inside the 0 – 40 °C TS3 envelope; the chamber was verified against a certified PRT before the sweep.

Conclusion

Prototype VCO-001 meets all four verification specifications covered by TP-001 and TP-002. The relaxation-oscillator topology with hand-matched NPN expo pair and passive +3300 ppm/°C compensation delivers musically usable accuracy across the full audio band and across the operating temperature range. The design is suitable for integration into the final synthesiser.

jm3767, eckl21, jf2280, kce27, sps80, yll201
