sps80-SaiSingaravelan/Synthesiser-Project/SynthesizerProject_QMS/Quality documents/Feasibility Documents/260428-Synthesizerproject-EEE-VCOWaveformQualityTestProtocol-v1-01.docx

Test Protocol — Waveform Quality

April 2026

Scope

This protocol verifies waveform quality of the triangle and square outputs of prototype VCO-001 at three representative audio frequencies, against the target specifications defined in the Feasibility Study FS-001.

Important — Test environment: VCO-001 is built on a solderless breadboard; it is NOT yet a finished module. Triangle and square outputs are taken directly from op-amp pins on the breadboard via hook-clip scope and analyser probes, rather than from 3.5 mm panel jacks. Power is supplied from a bench PSU via flying leads, not a Eurorack rack bus. Breadboard parasitic capacitance, inductance and contact resistance are present and may add small artefacts (especially HF ringing on the square edges) that would not appear on the final PCB.

Specifications Under Test

Ref | Target spec | Pass criterion
TS4a | Triangle THD ≤ 1 % at 100 Hz, 1 kHz, 10 kHz | THD (measured to 9th harmonic) ≤ 1.0 %
TS4b | Square duty cycle 50 % ± 2 % over the same frequencies | Duty within 48 % – 52 %

Equipment

Ref | Item | Required accuracy | Source
E1 | Precision DC source | ± 1 mV | University lab
E2 | Audio analyser, R&S UPV or Audio Precision APx515 | THD+N ≤ 0.005 % | University lab
E3 | Oscilloscope, 100 MHz, 1 GS/s | Duty-cycle meas. ± 0.1 % | University lab
E4 | Regulated ±12 V bench PSU | 1 A per rail | University lab
E5 | BNC cables and 10× passive probes | — | University lab

Set-up

- Power the breadboard from E4: clip +12 V to the red rail and −12 V to the blue rail using twisted-pair flying leads to keep loop area small; verify < 50 mV ripple at the supply rows of U1, U2 and U5 with E3.
- Tie the TUNE and LFO input rows on the breadboard to the 0 V rail with short jumper wires (these inputs are not exercised in TP-002).
- Connect E1 to the KEY input row via banana-to-flying-lead, returned to the breadboard 0 V rail.
- Connect E2 (audio analyser) to the TRI output (output of integrator U2 / buffer U6) using a BNC-to-clip lead direct to the op-amp output pin and a short ground clip to the adjacent 0 V row. Avoid long ground returns: they pick up mains hum and corrupt the THD reading.
- Connect channel 1 of E3 to the SQR output (output of comparator U5) via a 10× passive probe with the spring-tip ground accessory pressed onto the same 0 V row. The short ground tip is essential for clean measurement of HF edges on the breadboard.
- Allow VCO-001 to warm up for 15 min at 25 °C before taking readings; the breadboard takes longer to thermally equilibrate than a PCB.

Procedure

- Step 1. Set KEY to produce nominal 100 Hz (read with E3 on the SQR row, trim the breadboarded TUNE trimmer).
- Step 2. On E2, select THD mode, window = flat-top, sweep harmonics H2…H9; record THD %. Note: do NOT touch the breadboard during the measurement — finger capacitance shifts the integrator pole and corrupts the THD reading.
- Step 3. On E3, read duty cycle of SQR; record in the data sheet.
- Step 4. Repeat steps 1–3 for 1 kHz (KEY ≈ 4.322 V) and 10 kHz (KEY ≈ 7.644 V).
- Step 5. Inspect the triangle on E3; confirm no discontinuity or clipping at peaks. Some ringing on the SQR edges at 10 kHz is expected due to breadboard parasitic L/C — it is acceptable provided it does not push the duty reading outside the pass window.
- Step 6. Record ambient temperature at start and end; note if it changes by > 1 °C.

Recorded Data

Recorded data from execution of the protocol on the breadboarded prototype VCO-001, ambient 22.8 °C, supply ±12.02 V / ±11.98 V from bench PSU. Triangle output measured into the audio analyser via clip-lead direct to the op-amp output pin; square output measured on the oscilloscope via 10× probe with spring-tip ground. The 'small ringing on SQR edges' note at 10 kHz is attributed to breadboard parasitic L/C and is expected to disappear on the final PCB build.

Target f (Hz) | Measured f (Hz) | THD (%) | Duty (%) | Notes
100 | 100.04 | 0.41 | 50.3 | Clean
1 000 | 1 000.17 | 0.52 | 50.1 | Clean
10 000 | 10 002.3 | 0.89 | 49.6 | Small ringing on SQR edges

TS4a: highest measured THD = 0.89 % at 10 kHz, below the 1.0 % limit. PASS. TS4b: duty cycle stays in 49.6 – 50.3 %, well within the 48 – 52 % window. PASS.

Acceptance Criteria

- TS4a: THD ≤ 1.0 % at all three frequencies → PASS.
- TS4b: duty cycle 48 % – 52 % at all three frequencies → PASS.
- A FAIL on either criterion triggers a design change, raised against FS-001.

jm3767, eckl21, jf2280, kce27, sps80, yll201
