sps80-SaiSingaravelan/Synthesiser-Project/SynthesizerProject_QMS/Quality documents/Feasibility Documents/260315-Synthesizerproject-VCFResonanceVerificationTestResults-V1.docx

VCF Resonance Verification Test Results

Date: 15/03/26

1. Purpose

The purpose of this document is to present the results of the resonance verification test and determine whether the VCF meets the resonance specification.

2. Related Protocol

VCF Resonance Verification Test Protocol

3. Test Summary

The VCF was analysed using an AC sweep in LTspice to observe the frequency response.

The resonance control was varied and the peak gain near the cut-off frequency was measured.

4. Results

Resonance Setting | Measured Peak Gain (dB) | Required Value | Pass/Fail
Low | 0.9 dB | < +3 dB | PASS
Medium | 2.8 dB | ≈ +3 dB | PASS
High | 3.6 dB | ≥ +3 dB ±1 dB | PASS

5. Analysis

The measured peak gain increased with the resonance control setting, showing predictable filter behaviour. At the high resonance setting, the peak gain reached 3.6 dB, satisfying the requirement of at least +3 dB within the allowed tolerance. No unwanted instability was observed during normal operation.

6. Verification Outcome

Resonance peak requirement: PASS / FAIL

Control behaviour requirement: PASS / FAIL

Stability requirement: PASS / FAIL

7. Conclusion

The VCF resonance verification test is considered PASS.

The measured peak gain of 3.6 dB at high resonance satisfies the requirement of +3 dB ±1 dB.

The resonance control produces a smooth and predictable increase in gain, and no instability was observed during operation.

The results confirm that the filter meets the aesthetic and performance requirements defined in the D&D matrix.

8. Notes

Possible causes of unexpected behaviour include excessive feedback gain or simulation limitations.

jm3767, eckl21, jf2280, kce27, sps80, yll201
