sps80-SaiSingaravelan/Synthesiser-Project/SynthesizerProject_QMS/Quality documents/Feasibility Documents/260315-Synthesizerproject-ADSROutputVoltageVerificationTestProtocol-V1.docx

ADSR Envelope Output Voltage Verification Test Protocol

Date: 15/03/26

1. Purpose

This test verifies that the ADSR envelope generator produces the correct voltage levels during the attack and sustain phases. Ensuring accurate voltage levels is essential for maintaining proper signal control in the synthesizer system.

2. Test Objective

To verify that the peak voltage and sustain voltage levels generated by the ADSR circuit match the design specification within acceptable tolerances.

3. Equipment Required

- Digital oscilloscope
- Digital multimeter
- ADSR envelope generator circuit
- Power supply
- Gate trigger signal source

4. Test Setup

1. Connect the ADSR circuit to a stable power supply.
2. Connect the oscilloscope probe to the output of the envelope generator.
3. Connect the multimeter in parallel to measure voltage levels.
4. Trigger the envelope generator using the gate signal.

5. Test Procedure

1. Trigger the ADSR envelope using the gate signal.
2. Observe the waveform on the oscilloscope.
3. Record the maximum voltage reached during the attack phase.
4. Measure the sustain voltage level during the sustain stage.
5. Repeat the measurement three times.
6. Record all measured values and calculate the average voltage.

6. Acceptance Criteria

The peak voltage should match the system design value (e.g., 5V + or - 5%). The sustain voltage should correspond to the configured sustain level within + or - 5% tolerance.

jm3767, eckl21, jf2280, kce27, sps80, yll201
