sps80-SaiSingaravelan/Synthesiser-Project/SynthesizerProject_QMS/Quality documents/Feasibility Documents/260315-Synthesizerproject-ADSRTimingVerificationTestProtocol-V1.docx

ADSR Envelope Timing Verification Test Protocol

Date: 15/03/26

1. Purpose

The purpose of this verification test is to confirm that the ADSR (Attack, Decay, Sustain, Release) envelope generator produces timing characteristics that meet the design specifications. The test measures the duration of each envelope stage to ensure the system performs within acceptable tolerance levels.

2. Test Objective

To verify that the attack, decay, sustain, and release stages of the envelope generator operate within + or - 10% of the target timing values defined in the system specifications.

3. Equipment Required

- Digital oscilloscope
- Gate trigger
- ADSR envelope generator circuit
- Stable DC power supply
- Oscilloscope probes

4. Test Setup

1. Connect the ADSR circuit to the power supply.
2. Connect the oscilloscope probe to the envelope output signal.
3. Use the gate signal to trigger the envelope generator.
4. Configure the oscilloscope to capture the full envelope waveform.

5. Test Procedure

1. Apply a gate signal to trigger the envelope generator.
2. Observe the envelope waveform on the oscilloscope.
3. Measure the attack time from 0V to the peak voltage.
4. Measure the decay time from the peak voltage to the sustain level.
5. Maintain the gate signal and verify the sustain voltage remains stable.
6. Remove the gate signal and measure the release time until the output returns to 0V.
7. Repeat the measurement three times to ensure repeatability.

6. Acceptance Criteria

The measured timing values for attack, decay, and release must fall within + or - 10% of the design specification. The sustain stage must maintain a stable voltage level during the gate signal.

jm3767,eckl21,jf2280,kce27,sps80,yll201
