sps80-SaiSingaravelan/Synthesiser-Project/SynthesizerProject_QMS/Quality documents/Feasibility Documents/260315-Synthesizerproject-Test2EnvelopeOutputVoltageVerification-V2.docx

Test 2 – Envelope Output Voltage Verification

Results

Voltage measurements were taken using both a digital multimeter and an oscilloscope to ensure accuracy and to observe the waveform characteristics. The measured values were compared with the expected design targets.

Parameter | Target Value | Measured Value
Peak Voltage | 5.0 V | 4.92 V
Sustain Voltage (50%) | 2.5 V | 2.48 V

All measured voltages are within the ±5% tolerance limit defined in the test protocol. The oscilloscope confirmed smooth transitions between voltage levels, with no visible instability or distortion.

Explanation

The measured peak voltage is slightly below the target value, with a difference of 0.08 V. This small discrepancy is well within tolerance and is likely due to non-ideal characteristics of the circuit components, such as voltage drops across operational amplifiers or minor inefficiencies in the power supply.

The sustain voltage closely matches the expected 50% level, indicating that the voltage division or control mechanism responsible for maintaining the sustain stage is functioning correctly. This suggests that the circuit is accurately regulating voltage levels during steady-state operation.

In practical analogue systems, such small variations are unavoidable due to component tolerances, internal resistances, and loading effects. The stability of the measured voltages over time is particularly important, and during testing, the output remained consistent without noticeable fluctuation. This indicates that the circuit design is robust and not significantly affected by noise or interference.

Conclusion

The ADSR envelope generator meets the required voltage specifications, with all measured values falling within acceptable tolerance limits. The circuit produces stable and accurate voltage levels for both peak and sustain stages, confirming correct operation.

These results demonstrate that the envelope generator is capable of reliably controlling signal amplitude, which is critical for consistent audio performance in a synthesiser system. The minor deviations observed are negligible and do not impact overall functionality. Therefore, the circuit is considered suitable for integration into the final design.

jm3767,eckl21,jf2280,kce27,sps80,yll201
