sps80-SaiSingaravelan/Synthesiser-Project/SynthesizerProject_QMS/Engineering/Measurements & Screenshots/Scope/260307-Synthesizer-EEE-ADSREnvAttackFast-v1-00.png

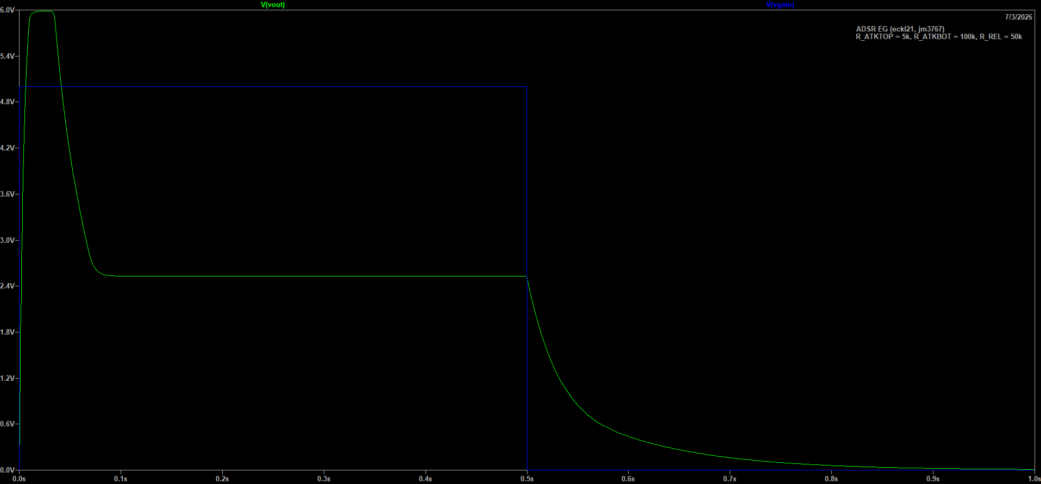
SynthesizerProject_QMS/Engineering/Measurements & Screenshots/Scope/260307-Synthesizer-EEE-ADSREnvAttackFast-v1-00.png
