sps80-SaiSingaravelan/Synthesiser-Project/SynthesizerProject_QMS/Engineering/Measurements & Screenshots/Scope/260307-Synthesizer-EEE-ADSREnvWaveform-v1-01.png

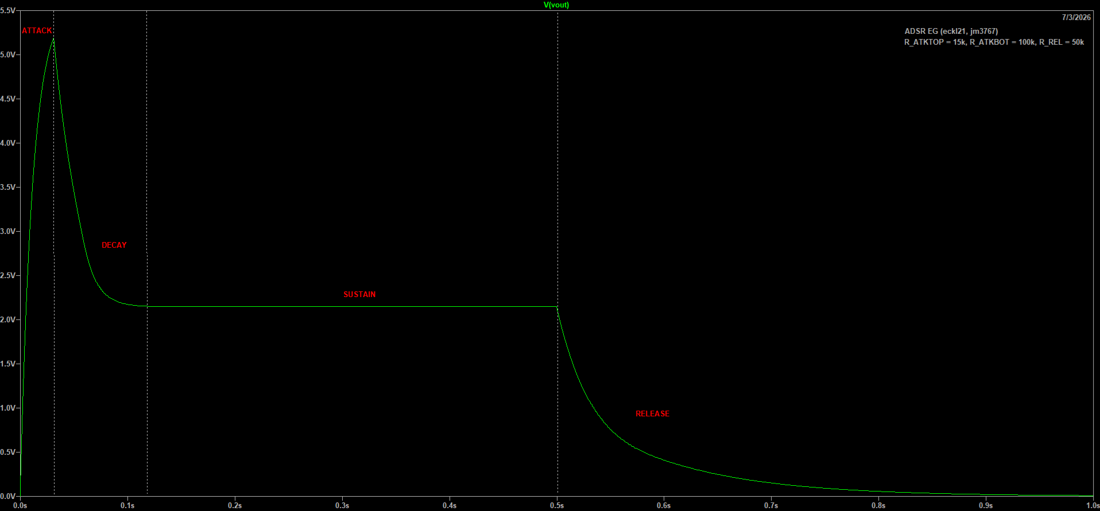
SynthesizerProject_QMS/Engineering/Measurements & Screenshots/Scope/260307-Synthesizer-EEE-ADSREnvWaveform-v1-01.png
