sps80-SaiSingaravelan/Synthesiser-Project/SynthesizerProject_QMS/Operations/Risk Mitigation/260328-Synthesizerproject-RiskAssessment-V1.docx

Risk Assessment

Design and Implementation of a Monophonic Analogue Synthesiser

kce27 | jm3767 | eckl21 | jf2280 | sps80 | yll201

## 1. Severity Scale Definition

The primary consideration for severity in this project is schedule impact, as the project is simulation-only with a fixed submission deadline. Severity is defined as follows:

Severity Level | Definition (schedule / deliverable impact for the Synthesiser project)
1 - Trivial | Negligible impact on project outcome. A minor simulation anomaly or formatting issue resolved within hours with no effect on deliverables.
2 - Minor | Small delay or rework (<1 day). One circuit block requires re-simulation; deliverable quality slightly reduced but all objectives still met.
3 - Moderate | Noticeable impact; 1-3 days of rework required. One work package milestone delayed; partial re-design of a module (e.g. VCF topology change).
4 - Serious | Significant impact; >3 days lost or a major module (VCO, VCF, VCA, ADSR) fails to meet specification. PCB tape-out delayed or incomplete.
5 - Catastrophic | Project fails to deliver core simulation results or PCB design. Multiple modules non-functional; final report cannot be submitted on time.

## 2. Periodicity (Likelihood) Scale Definition

Periodicity is defined quantitatively as the probability that the risk event occurs at least once during the project lifetime (approximately 10 weeks, Weeks 16-26):

Likelihood Level | Quantitative Definition (probability of occurrence during project lifetime)
1 - Remote | Probability <5%. Extremely unlikely in a well-managed, simulation-only project. Requires a highly unusual combination of circumstances.
2 - Unlikely | Probability 5-20%. Could occur but strong existing controls make it improbable (e.g. software failure with backups in place).
3 - Possible | Probability 20-50%. A realistic scenario that the team should actively plan against (e.g. tool-licence conflicts during peak usage).
4 - Likely | Probability 50-75%. Expected to occur at least once during the project unless controls are actively applied.
5 - Very Likely | Probability >75%. Almost certain to occur without active mitigation (e.g. team members missing meetings without a defined protocol).

## 3. Risk Acceptance Matrix

The matrix below shows all 25 risk rating combinations colour-coded by acceptability. Risks are ranked as LOW (green, rating 1–4), MEDIUM (orange, rating 5–9), or HIGH (red, rating 10–25).

| 1 Trivial | 2 Minor | 3 Moderate | 4 Serious | 5 Catastrophic
1 Remote | 1 | 2 | 3 | 4 | 5
2 Unlikely | 2 | 4 | 6 | 8 | 10
3 Possible | 3 | 6 | 9 | 12 | 15
4 Likely | 4 | 8 | 12 | 16 | 20
5 Very Likely | 5 | 10 | 15 | 20 | 25

LOW (1-4) | Acceptable - monitor periodically
MEDIUM (5-9) | Requires mitigation - add controls before proceeding
HIGH (10-25) | Must be avoided - stop activity until reduced to medium or low

## 4. Risk Assessment Matrix

The table below lists seven identified project risks, ranked from highest initial risk rating to lowest. Initial risk ratings reflect the position before additional mitigations are applied. The final columns show the revised severity, likelihood, and rating after additional controls are implemented.

# | Hazard Identified | Existing Controls & Measures | Sev (a) | Lik (b) | Rating (a×b) | Additional Mitigation Required | Sev (a) | Lik (b) | New Rating

1 | Key team member unavailability - illness, personal circumstances, or workload from other units prevents a team member from completing their assigned tasks on time. | Task responsibilities distributed across 6 members. Gantt chart identifies dependencies. Teams communicate via shared group chat. | 4 | 4 | 16 | Introduce cross-training: each major work package has a named primary and a named secondary owner. Weekly check-ins (documented in meeting minutes) flag capacity issues early. Buffer time of 3 days built into the Gantt chart before each milestone. | 2 | 2 | 4
2 | Inadequate version control - overwriting or loss of simulation files, schematics, or documentation due to absent or inconsistent use of version control. | Files stored in a shared folder. Team members aware of the need to back up work. | 5 | 3 | 15 | Mandate use of a structured Git repository (GitHub) for all project files from Week 1. Enforce a commit-per-session policy with meaningful commit messages. Designate a repository manager responsible for checking daily activity. Enable automatic cloud sync as a secondary backup. | 2 | 2 | 4
3 | Simulation model divergence - circuit simulations (e.g. VCF or ADSR) fail to converge or produce incorrect results, preventing validation of the module. | Simulation software (LTSpice) used by all team members. Schematic peer-reviewed before simulation run. | 4 | 3 | 12 | Adopt iterative simulation strategy: simulate each sub-block independently before integration. Use known reference circuits as sanity checks. Schedule a dedicated 2-hour debug session per module within the Gantt chart if first-pass simulation fails. | 3 | 1 | 3
4 | Interconnection issues between modules - when VCO, VCF, VCA, and ADSR are integrated into a complete signal chain, impedance mismatches or signal level incompatibilities cause unexpected behaviour. | Voltage and impedance ranges defined in WP2 system specification. Individual modules validated in isolation before integration. | 4 | 3 | 12 | Define formal interface specifications (signal levels, output impedance, input impedance) for every module-to-module connection in WP2. Simulate each interface connection separately before full chain integration. Use unity-gain buffers in simulation to isolate loading effects. | 3 | 1 | 3
5 | Software / licence failure - simulation or PCB CAD tool (OrCAD/KiCAD/LTSpice) becomes unavailable due to licence expiry, university IT outage, or version incompatibility. | University provides site licences. Multiple team members have tools installed locally. KiCAD (open-source) available as fallback for PCB work. | 3 | 3 | 9 | Document and share tool installation instructions and licence activation steps at project start. Designate KiCAD as the fallback PCB tool. Store all project files in a shared cloud repository (GitHub) so any team member can continue work on any machine. | 2 | 2 | 4
6 | Scope creep - additional features (e.g. MIDI interface, digital control, polyphony) are informally added mid-project, consuming time budgeted for core deliverables. | Scope explicitly defined and exclusions documented in the project management plan. Changes require group agreement. | 3 | 3 | 9 | Implement a formal change-control procedure: any proposed scope change must be submitted in writing to the group, assessed for time/resource impact, and approved by majority vote before adoption. Review scope boundary at each milestone gate. | 2 | 2 | 4
7 | PCB design rule check (DRC) failures - layout errors (clearance violations, unrouted nets, incorrect footprints) are discovered late, delaying Gerber file generation. | DRC run iteratively during layout. Peer review of PCB before sign-off included in WP4 tasks. | 4 | 2 | 8 | Adopt a staged PCB review process: schematic-level ERC completed before layout begins; intermediate DRC at 50% layout completion; final DRC and independent peer review before Gerber export. Assign a dedicated PCB checker role within the team. | 1 | 2 | 2
