sps80-SaiSingaravelan/Synthesiser-Project/SynthesizerProject_QMS/Engineering/Circuit Simulation/EG/260307-Synthesizer-EEE-ADSRENV-v3-00.asc

C1: cap; 1µ
C2: cap; 1µ
D1: diode
D2: diode
D3: diode
D4: diode
D5: diode
D6: zener; myZ
Q1: npn
R1: res; 30k
R2: res; 10k
R3: res; 100k
R4: res; 10k
R5: res; 100k
R6: res; 1k
R7: res; 75k
R8: res; 100k
R9: res; 50k
R10: res; 50k
R_ATKBOT: res; 100k
R_ATKTOP: res; 15k
R_LOAD: res; 1MegA
R_REL: res; 500k
U1: LT1013
U2: LT1013
U3: LT1013
U4: LT1013
V1: voltage; PULSE(0 5 0 1u 1u 500m 1s)
V2: voltage; 9V
V3: voltage; -9V
Named nets: 0, VGATE, +9V, -9V, VOUT, BURST
.tran 0 1s 0 10us
ADSR (Attack-Decay-Sustain-Release) Envelope Generator
 
eckl21, jm3767
.model myZ D(BV=6 IBV=1m)
