sps80-SaiSingaravelan/Synthesiser-Project/SynthesizerProject_QMS/Engineering/Circuit Simulation/VCA/260311-Synthesizer-EEE-VCOSchmitt-v1-00.asc

C1: cap; 2.2µ
D1: diode; 1N4148
R1: res; 10k
R2: res; 10k
R3: res; 10k
R4: res; 1Meg
U1: LT1013
V1: voltage; 9
V2: voltage; -9
Named nets: 0, +9V, -9V, V_C
.tran 0 0.5s 0 10u
