sps80-SaiSingaravelan/Synthesiser-Project/SynthesizerProject_QMS/Engineering/Circuit Simulation/VCF/260313-SynthesizerProject-VCF-V1.asc

C1: cap; 10nF
C2: cap; 10nF
C3: cap; 1µF
C4: cap; 1µf
C5: cap; 0.05µF
D1: diode
D2: diode
D3: diode
D4: diode
Q1: npn
R1: res; 5k
R2: res; 5k
R3: res; 100k
R4: res; 10k
R5: res; 3.5k
R6: res; 50k
R7: res; 50k
R8: res; 200k
R9: res; 200k
R10: res; 1k
R11: res; 20k
R12: res; 100k
R13: res; 51k
R14: res; 50k
R15: res; 100k
R16: res; 51k
R17: res; 51k
U1: LT1013
U2: LT1013
U3: LT1013
U4: LT1013
U5: LT1013
U6: LT1013
V1: voltage; PULSE(0 5 10m 1n 1n 200m 500m)
V3: voltage; 5
V4: voltage; 12
V5: voltage; -12
V6: voltage; -5
Named nets: 0, V+, V-, VOUT, Vin, Vout, Vhalf, VCC
R1 R2 5k-100k stero pot
R7 R6 100k Potentiometer
Fully resonant LPF
soft clipper
Resonance limiter
Output 1(Square)
Output 2(Triangle)
.tran 0 50ms 0 20u
.ic V(n001)=0.01
