sps80-SaiSingaravelan/Synthesiser-Project/SynthesizerProject_QMS/Engineering/Circuit Simulation/VCF/260314-SynthesizerProject-VCF-V2.asc

C1: cap; 100nF
C2: cap; 100nF
C3: cap; 1µF
C4: cap; 1µf
C5: cap; 0.05µF
Q1: npn
R1: res; 50k
R2: res; 50k
R3: res; 100k
R6: res; 10k
R7: res; 10k
R8: res; 200k
R9: res; 100k
R10: res; 1k
R11: res; 20k
R12: res; 100k
R13: res; 51k
R14: res; 50k
R15: res; 100k
R16: res; 51k
R17: res; 51k
U1: LT1013
U2: LT1013
U3: LT1013
U5: LT1013
U6: LT1013
V1: voltage; PULSE(0 5 10m 1n 1n 200m 500m)
V3: voltage; 9
V4: voltage; 12
V5: voltage; -12
V6: voltage; -9
Named nets: 0, V+, V-, Vin, Vout, Vhalf, VCC
R1 R2 5k-100k stero pot
R7 R6 20k Potentiometer
Fully resonant LPF
Output 1(Square)
Output 2(Triangle)
.tran 0 1s 0 20u
.ic V(n001)=0.01
