sps80-SaiSingaravelan/Synthesiser-Project/SynthesizerProject_QMS/Engineering/Circuit Simulation/VCO/260313-SynthesizerProject-VCO-V1.asc

C1: cap; 0.05µF
Q1: npn
R1: res; 10k
R2: res; 100k
R3: res; 51k
R4: res; 50k
R5: res; 100k
R6: res; 51k
R7: res; 51k
U1: LT1013
U2: LT1013
V1: voltage; 1.3243
V2: voltage; 5
V3: voltage; -5
Named nets: 0, Vin, Vout, Vhalf, VCC
Output 1(Square)
Output 2(Triangle)
.tran 0 50ms 0 20u
.ic V(n001)=0.01
