sps80-SaiSingaravelan/Synthesiser-Project/SynthesizerProject_QMS/Engineering/Circuit Simulation/VCO/260331-Synthesizer-EEE-VCO-sps80-jf2280-v2-00.asc

C2: cap; 10n
Q3: npn
R1: res; 1k
R2: res; 10k
R3: res; 2k
R4: res; 10k
R5: res; 10k
R6: res; 1k
R7: res; 1k
R8: res; 100K
R9: res; 10k
R10: res; 47K
R11: res; 10k
R12: res; 10k
R13: res; 10k
R14: res; 1k
R15: res; 10k
R16: res; 100K
U1: UniversalOpamp2
U2: UniversalOpamp2
U3: UniversalOpamp2
U4: UniversalOpamp2
U5: UniversalOpamp2
U6: UniversalOpamp2
V1: voltage; 5V
V2: voltage; -5V
V3: voltage; 3.0833
V5: voltage; ""
Named nets: VCC, VEE, 0, KEY, LFO, INPUT, TRIANGLE, SQUARE
.tran 0 50ms 0 1u
VCO (sps80, jf2280)
